phorton1/Arduino-theClock3/docs/wood.md

# theClock3 - Laser Cut and Assemble Wooden Parts (Build Continued)

**[Home](readme.md)** --
**[Design](design.md)** --
**[Plan](plan.md)** --
**Wood** --
**[Coils](coils.md)** --
**[Electronics](electronics.md)** --
**[Firmware](firmware.md)** --
**[Assemble](assemble.md)** --
**[Build](build.md)** --
**[Tuning](tuning.md)** --
**[UI](ui.md)** --
**[Software](software.md)** --
**[Troubles](troubles.md)** --
**[Notes](notes.md)**

On this page we will describe how to:

- [Cut the Wood](#1-cut-the-wood)
- Assemble the [Frame](#2-assemble-the-frame)
- Assemble the [Face](#3-assemble-the-face)
- Glue washers to the [Arms](#4-glue-washers-to-the-arms)
- Sand and paint the [Gears and ther small parts](#5-sand-and-paint-parts)
- Align and glue the [Gear Sets](#6-align-and-glue-gear-sets) together

Note that there are no *wood stains* used in this project.  All I use is a
lacquer based **clear coat** on the parts and let the natural colors of the
different types of wood show through.

## 1. Cut the Wood

Here is a screen grab of the Lightburn [AllParts.lbrn2](lightburn/all_parts.lbrn2)
project showing and naming all of the wooden parts that are laser cut.

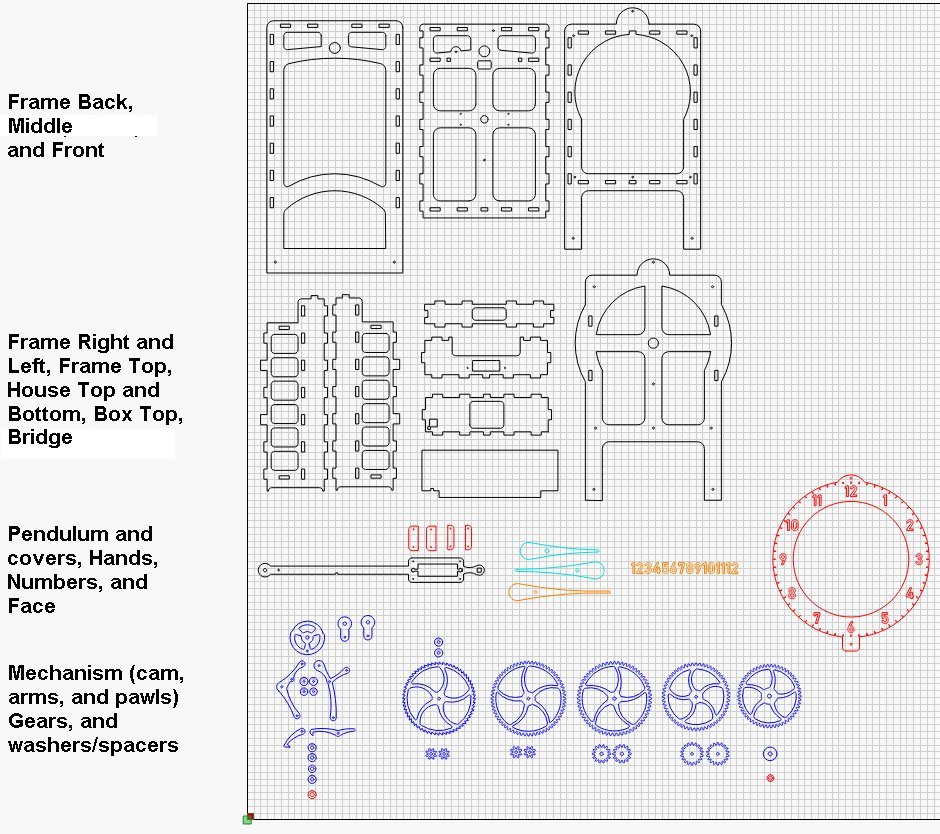
[picture p40: docs/images/wood-AllParts.jpg]


- <font color='black'><b>black</b></font> parts are cut from **cheap 3/16" plywood**
- <font color='blue'><b>blue</b></font> parts are cut from better quality **3/16" birch plywood**
- <font color='red'><b>red</b></font> parts are cut from **1/8" birch plywood**
- <font color='cyan'><b>cyan</b></font> parts are cut from **1/8" maple** hardwood
- <font color='orange'><b>orange</b></font> parts are cut from **1/8" walnut** hardwood

I specifically cut the **pendulum** out of better **3/16 walnut plywood** that
I happen to have.  It is more rigid and a bit thicker than the birch or cheap plywood.

I usually sand both sides of the frame *plywood* pieces with an electric
**palm sander** before cutting the parts out.  I sand the smaller pieces
individually after they are cut.

On my **10 Watt Diode Laser** I typically cut the 3/16" wood with two passes at
**95% power** and **140 mm per minute**.  I cut the 1/8 wood a bit quicker
at **90% power** and **150 mm per minute**.  Test cuts and adjustments
are required to get the best cut quality.

*There is **nothing worse** than cutting a sheet full of parts and finding that
the cuts did not go all the way through!!  It is usually impossible to fix it,
and so the wood gets wasted.  Therefore I prefer to **over-do** it a little bit,
even at the expense of **charring** the wood to ensure that all parts are
completely cut out.*

For the **smaller parts** (small gears, cam, arms, pawls, spacers, etc),
since I can usually fit them in the blank spaces of other parts, I typically print
twice as many as I need and select the better looking ones for the assembly.

There are separate **Lightburn Projects** in this repository for each of the different
pieces of wood that I cut.

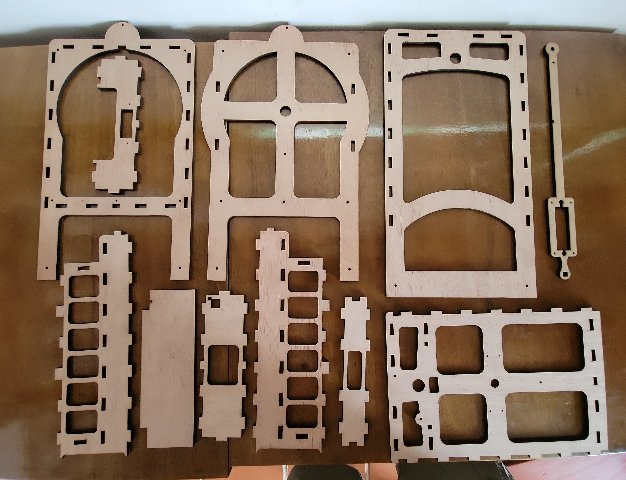
[picture p41: docs/images/wood-big_pieces.jpg]

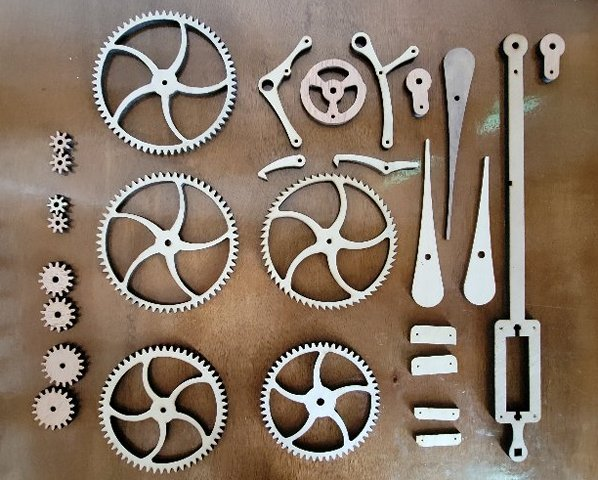
[picture p42: docs/images/wood-mechanism_and_gears.jpg]


Where possible, for all the big parts, immediately after cutting
I rub down the laser cuts with a **paper towel** to remove as much
of the charcoal as is easily done before moving them to my work table.
The process of cleaning and sanding the laser cut parts is surprisingly
*messy* and I find that I need to wash my hands often to prevent the
oil from my hands combining with the charcoal dust and leaving marks
in the wood.

It is **important** to keep track of, and to use the correct **wooden washers and spacers**
throughout the build process.  For example, there is only a *slight difference* between
the **12x2.85mm** spacers that support the arms, and are glued to the frame, and
the **11x3mm** washers that are glued to the front of the arms:

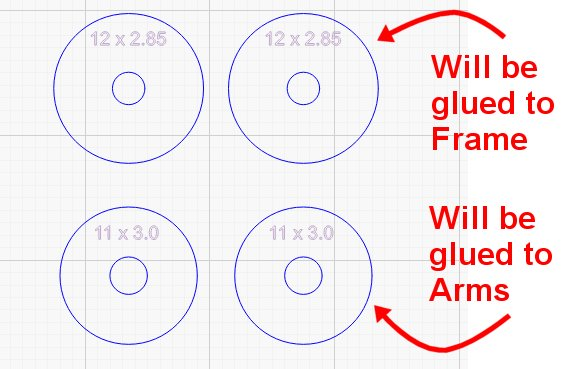
[picture p43: docs/images/wood-arm_and_frame_spacers.jpg]

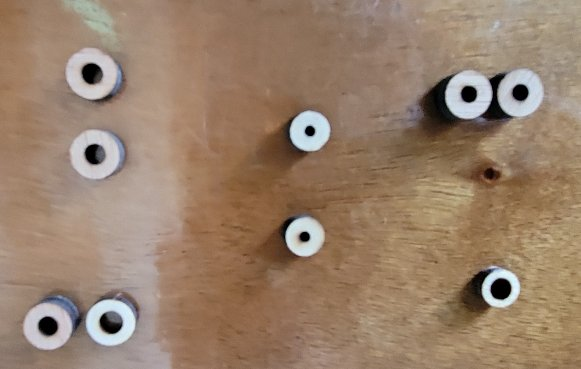
[picture p44: docs/images/wood-spacers_and_washers.jpg]


The **sizes** of the various washers and spacers is included as a
*non-cutting layer* in the various **Lightburn** projects so that
can see them, but it is **up to you** to keep track of them!

## 2. Assemble the Frame

It is important to dry fit the frame together and know ahead
of time how you will assemble and clamp it.  It is also
is important to understand that there are four tabs
that *extend out of the frame front* onto which the **bridge** (which
is NOT glued, but which is attached with screws) is aligned.

I usually use a piece of 2x2 wood as a mallet to tap the
pieces together as I align them.  As is typical with these kinds
of **box joints**, some tapping, force, and/or slight bending of the pieces
may be necessary to get the tabs to go into the slots.

Glue the frame together, in *one fell swoop*, with **wood glue** before
clamping it together!! The order of assembly of the frame is important,
is shown in the below **animated GIF**, and it is necessary that **all
pieces are in place, and square** before any **glue sets up** !!!

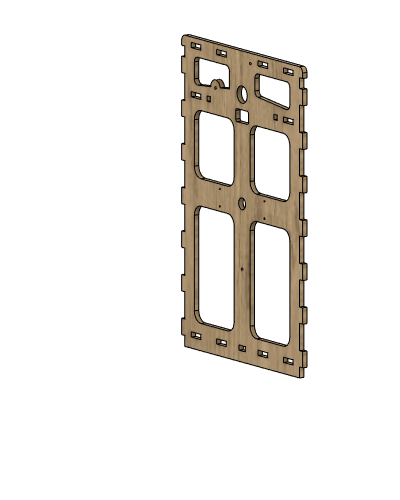
[picture p45: docs/images/wood-frame_assembly.gif]


Starting the with the **middle** frame piece, glue the
**house top**, **house bottom**, and **frame top** to it. Then,
while holding those pieces roughly in place, turn it on it's side
and glue **one of the frame sides to that**, then flip it over and
glue the **other frame side to that**. Then glue
the **frame back**, and, finally, **the frame front**.

**Clamp** the frame together and let it dry thoroughly ...

When it is thoroughly dry, lightly sand **the assembled frame**,
and the separate **bridge piece** with 300 grit sandpaper.

### Glue the Arm Spacers to the Frame

- *thread* **M3x8 machine screws** through the two **12x2.85mm** Arm Spacers
- *apply* **Wood Glue** to the back of the spacers
- *screw* them into the *Frame* until they are **tight** and let the glue *dry thoroughly*
- *remove* the screws

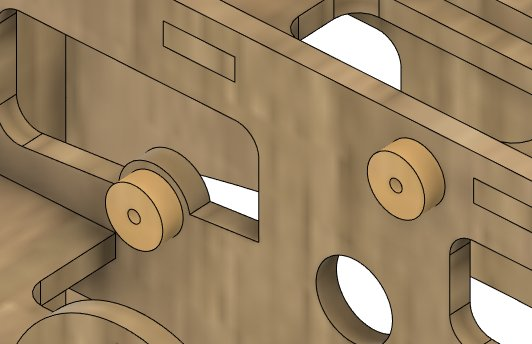
[picture p46: docs/images/wood-arm_spacers_glued.jpg]


### Clear Coat the Frame and Bridge

**Clear Coat the Frame and Bridge** by applying 2-3 clear-coats to the interior
of the frame and back of the bridge, and 3-4 coats to the
exterior and front.

## 3. Assemble the Face

The **hash marks** on the *face* are engraved before cutting.
**Finish sand** the face **before** cutting it and try to handle
it as little as possible before clear-coating!

**IT IS IMPORTANT TO KEEP THE LITTLE PIECES INSIDE OF THE 6,8,9, and 10 NUMBERS
WHEN CUTTING THE FACE**.  As I result I **do not** print the face
on my honeycomb laser printing surface or those small pieces will
fall into the honeycomb, be harder than heck to find, and will likely
be damaged by the laser.  Instead I cut the face **directly
on the laser table** and carefully keep track of where the
little pieces come from, and where they go, so that I can *match the grain*
when I re-insert them during the face assembly.

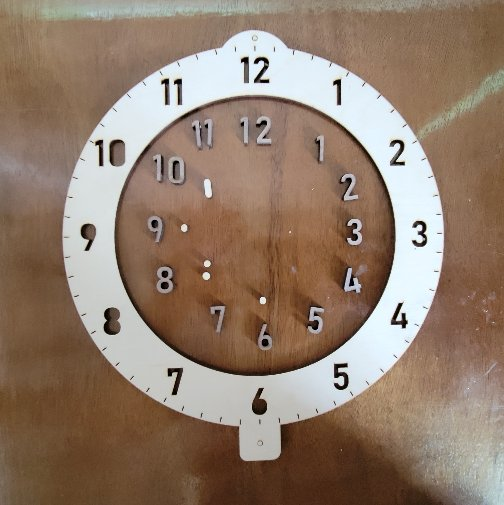
[picture p47: docs/images/wood-face_and_numbers.jpg]

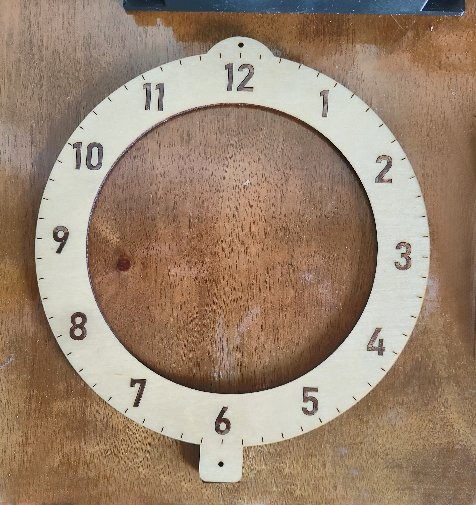
[picture p48: docs/images/wood-face_finished.jpg]


After wiping it off with a clean paper towel,
I place the **face** downwards on a sheet of wax paper and glue
the numbers in with **white glue**, inserting them from the back
so that they are *flush with the front of the face*.  Then
after the glue is thoroughly dry, I rough sand the back as needed
and *gently* sand the face with 320 grit sand paper until it
looks clean enough to clear coat.  **Vacuum** and wipe the dust
off with a clean paper towel.

I try to clear coat things as soon after I finish-sand them as
possible.  I clear coat the important (front) surface first so
that it is sealed as cleanly as possible before I flip them over
and paint the backs.  I apply as many as 5-6 clear-coats on the
face of the clock, sanding each coat lightly with 320 grit, and
rubbing the last coat down with a clean paper towel,
to get a nice sheen.

## 4. Glue Washers to the Arms

- Apply **wood glue** to the back of the two **11x3mm** *Arm Washers*
- **Align** and *press* the Washers onto the Arms

It is **important** that the Washers are *aligned* with the holes in the *Arms*.
They need to be aligned such that they **turn freely** on **M3 machine screws**

This is best done **by eye** and by **holding the parts together** with your
*fingers* until the glue has gotten to the point where you can, perhaps,
apply a *clamp* (or lay them down and put a small *weight* on top of them).

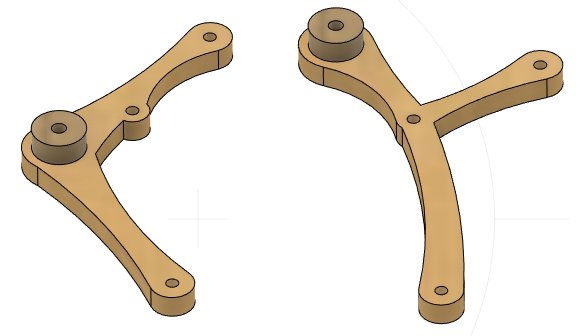
[picture p49: docs/images/wood-glue_washers_to_arms.jpg]


## 5. Sand and Paint Parts

My *least favorite* part of the entire build process is **sanding the gears**
and the rest of the small parts.

A. **Inspect each gear carefully**.  If there are any *defective* or *delaminated*
teeth they need to be **repaired** (or another instance of the particular gear
needs to be re-cut with the laser).  I have used wood glue, epoxy glue, and
even the **baking soda and super glue** trick to repair individual teeth on
gears before and during the sanding process.

B. **Make sure the ends of your brass tubes are sanded and smooth** before
inserting them into parts so that they don't damage the holes!
Test fit all the pieces onto their appropriate brass tubes.
Make sure the **pendulum, gears, cam,** and **hands** fit onto
the correct sized brass tubes so that they **fit snugly**.
You *may* need to lightly sand the holes so that the tubes go in, but,
**DONT OVERDO IT!!**

It is better if the *cam and pendulum* are a little easier to move
when later adjusting the clock but it is particularly important that
the **hands are snug** when compression fit on their particular brass tubes.

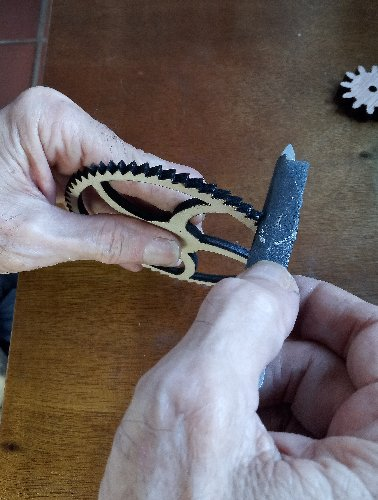
[picture p50: docs/images/wood-gears1.jpg]

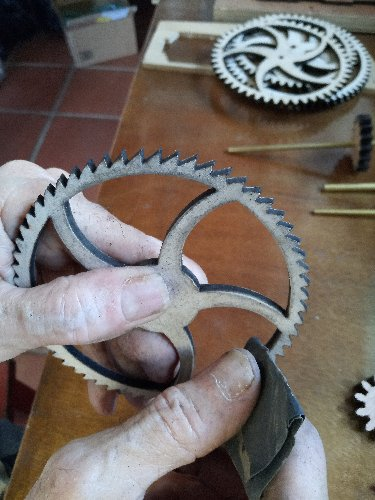
[picture p51: docs/images/wood-gears2.jpg]


C. For **each gear** and **every tooth** sand them *lightly* with 220 or 300
grit sand paper. You have to be very careful when sanding the gears to **NOT**
delaminate the plywood and chip the gears!!

D. For the **big gears**, after sanding the teeth, sand the **interior openings**
then clean everything with a paper towel before sanding the **back** and **face**
of each gear until they are clean enough to clear-coat.  This is an *art* more
than it is a *science*.  **Do your best!!** ... you won't regret taking the
time needed to make the gears as functionally and aesthetically
nice as possible.

E. The **faces of the pawls** and the **contact points** on the cam will also need
to be smooth.  The process varies with my feelings.  Sometimes I clear-coat them
first and then only sand these pieces once afterwards to minimize the
amount of material removed.

F. In any case, it is important to **apply several clear-coats** to the gears,
particularly *saturating the **teeth** and **contact points***.
The clear coat adds significant strength and **wear resistance** to these
parts.

G. After clear coating and allowing to dry thoroughly, **re-sand each tooth**
and all **contact points** to minimize friction.  I like to do the second
sanding of the small (pinon) gears by aligning each pair of pinon gears
on a **brass tube** and then doing the second pass at sanding their teeth
*before* doing any gluing.

I also give a *light sand* with *320 grit* paper to all of the **faces**
of the *gears, arms, pawls,* and *arm supports* .. any place where two
pices of wood will be facing each other.

## 6. Align and Glue Gear Sets

Each **gear set** consists of one large gear with two smaller *pinon gears*
(or one *spacer*) glued together in a *stack*.  I use *5 minute epoxy* to glue the gears together.

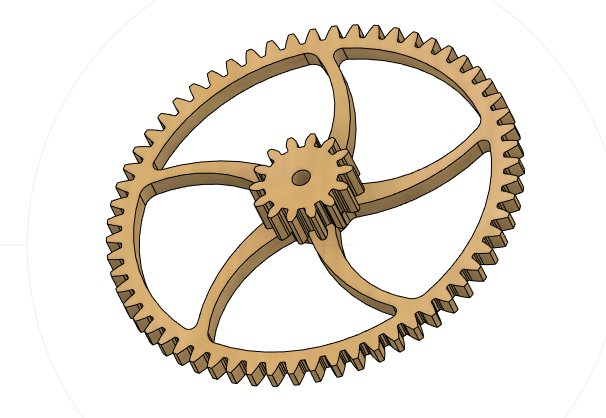
[picture p52: docs/images/wood-gears0.jpg]


The following picture shows the big gears and each pair of smaller gears
(or the single spacer) to be glued to the big gears, in their **proper orientation**.

- the **seconds wheel** is glued to the two (smallest) **min1a** gears
- the (largest) **min1b** gear is glued to the two (2nd smallest) **min2a** gears
- the (2nd largest) **min2b** gear is glued to the two **hour1a** gears
- the **hour1b** gear is glued to the two **hours2a** gears, and
- the final (smallest big) **hours2b** gear is glued to the (single) **hour spacer**

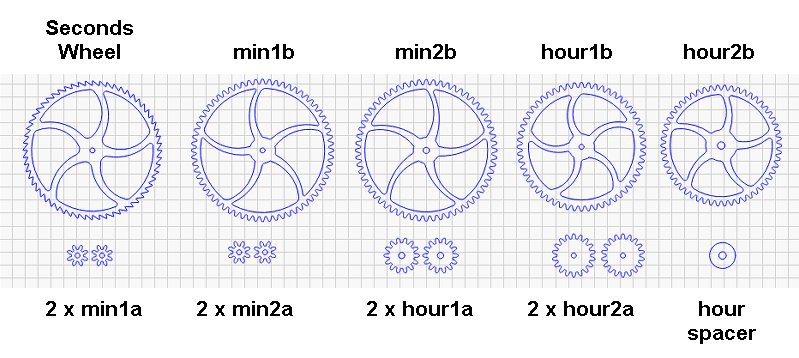
[picture p53: docs/images/wood-gears_and_names.jpg]


A. Jury rig an apparatus so that you can **spin the gears** and **align them**
as the glue is setting up.  For instance the **4 mm tubes** turn nicely
on **3mm threaded rods**, so for those gears that go on 4mm tubes I rig
up a contraption with a 3mm threaded rod on which I can spin the 4mm tube
and it's gears.  Likewise the 5mm tubes spin nicely on 4mm tubes, so I
then rig it up with a protruding (fixed) 4mm tube so that I can spin the
5mm tubes and it's gears during the alignment process.

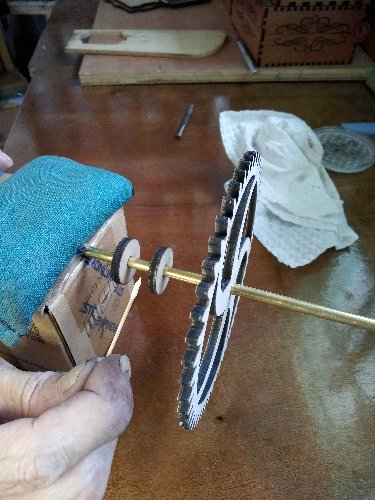
[picture p54: docs/images/wood-gears3.jpg]


*Note: above photo is an assembly from a previous clock.  Be sure
to glue the **correct gears** together (as shown in the previous image) in their
**proper orientation!!***
Also ***note*** that, wheras there are always **two** small *pinon gears* glued
to the larger gears, there is **only one** *3/16" spacer* glued to the front
of the *Hours2b* gear.

B. **BE CAREFUL NOT TO GLUE THE GEARS TO THE TUBES!!**.  We will
**cut the tubes later** and we don't want to damage the tubes
during this process.

C. Apply a small amount of **5 minute epoxy** glue as needed,
press the three gears together on the tube, **spin** them, and **adjust**
them get them as **square as possible** before the epoxy sets up.

Any *wobbles* introduced at this point will be permanent (as I learned
the hard way a few times) so **take your time** and glue and **align**
each gear sub-assembly on the (raw) brass tubes. If you end up with
a **wobbly gear** it is probably better to just re-cut, re-sand,
and create a new assembly than to try to use a mis-aligned gear
asembly in your finished clock!

D. After the glue has **set up** (about 5 minutes), slide the sub-assembled
gears off the tubes and set them aside.  **CLEAN THE TUBES WITH ALCOHOL**
after each subassembly.

**Next:** Winding the [**Coils**](coils.md) ...
