phorton1/Arduino-theClock3/docs/images/coils-final2.jpg

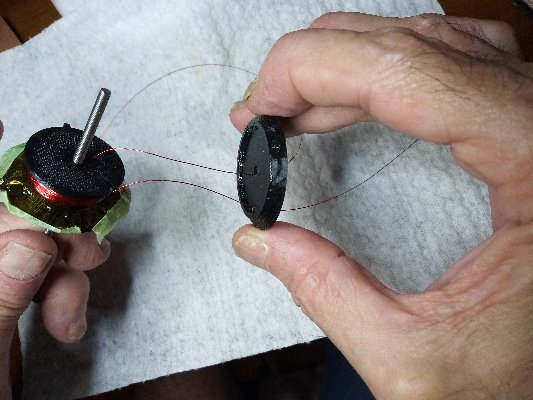
docs/images/coils-final2.jpg
