phorton1/Arduino-theClock3/docs/images/coils-insert2.jpg

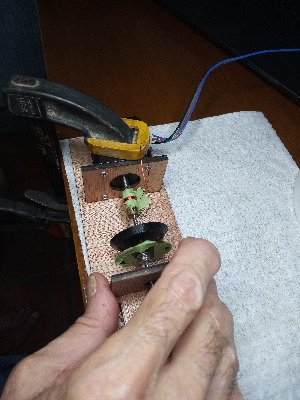
docs/images/coils-insert2.jpg
