phorton1/Arduino-theClock3/docs/images/ui-stats.jpg

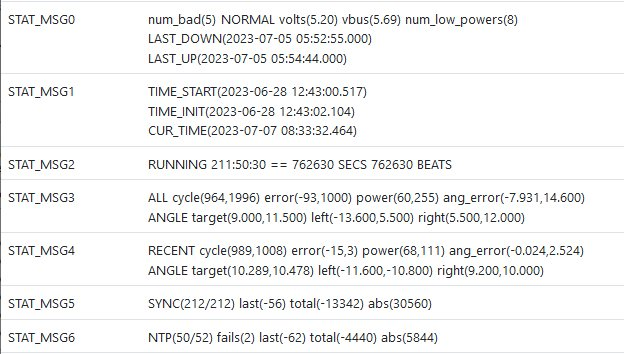
docs/images/ui-stats.jpg
