phorton1/Arduino-theClock3/docs/images/UPS1.png

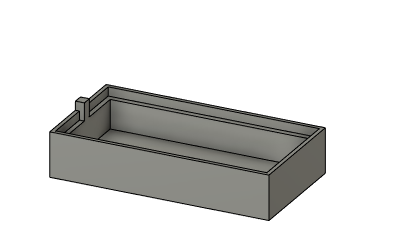
docs/images/UPS1.png
