phorton1/Arduino-theClock3/docs/images/UPS3.png

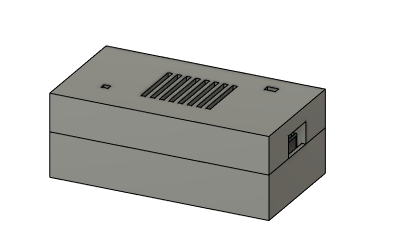
docs/images/UPS3.png
