phorton1/Arduino-theClock3/docs/fusion/dxf/spacers_main_front.dxf

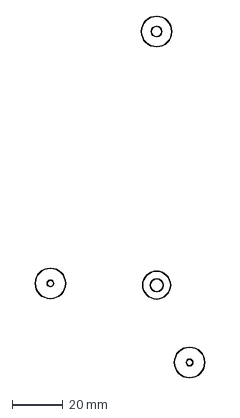
[picture p100: CAD file, 2023-05-27]
docs/fusion/dxf/spacers_main_front.dxf
66.8 x 142.5 mm
