phorton1/Arduino-theClock3/docs/fusion/dxf/bridge.dxf

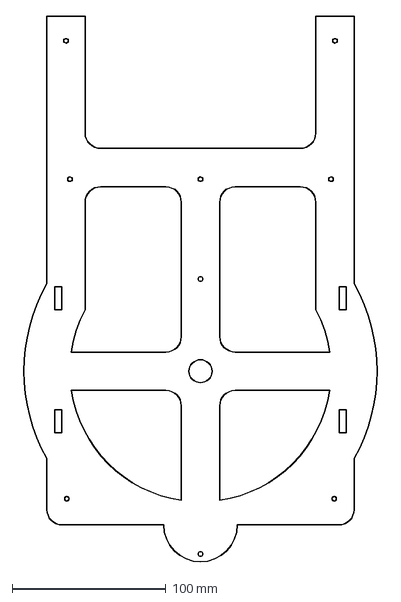
[picture p101: CAD file, 2023-06-24]
docs/fusion/dxf/bridge.dxf
240.0 x 355.0 mm
