phorton1/Arduino-theClock3/docs/fusion/stl/ups_bottom.stl

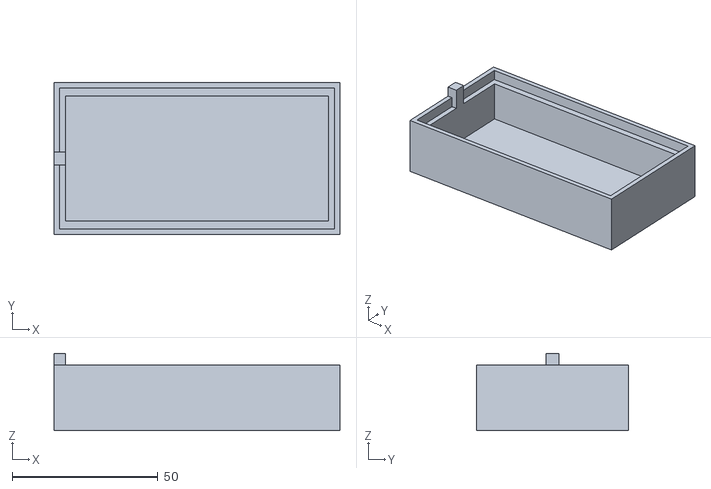
[picture p102: CAD file, 2023-07-10]
docs/fusion/stl/ups_bottom.stl
98.0 x 52.0 x 26.5
