phorton1/Arduino-theClock3/docs/prusa/UPS.3mf

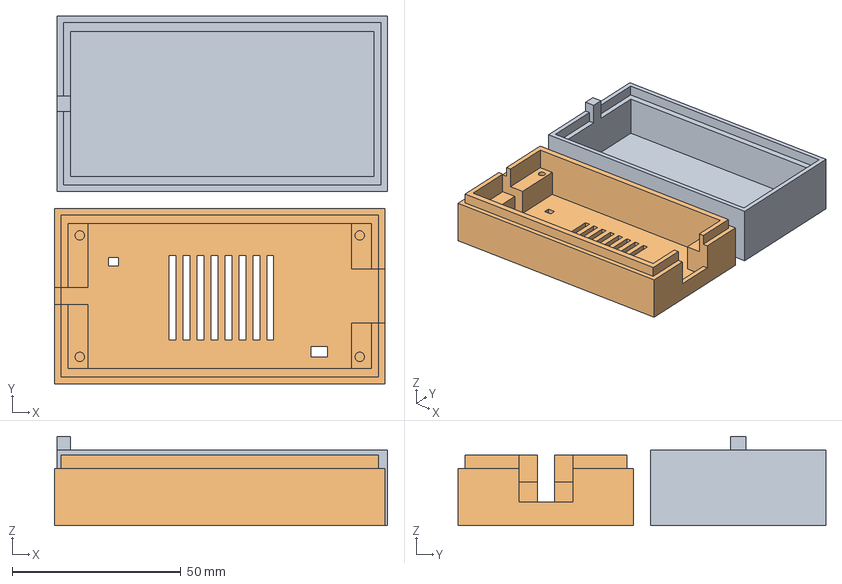
[picture p103: CAD file, 2023-07-10]
docs/prusa/UPS.3mf
98.7 x 109.0 x 26.5 mm
ups_bottom.stl
ups_top.stl
