phorton1/Arduino-theClock3/docs/fusion/dxf/arms.dxf

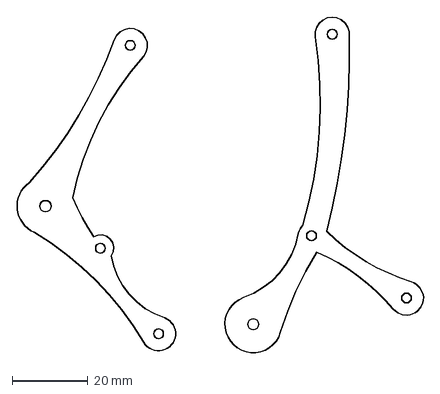
[picture p104: CAD file, 2023-05-27]
docs/fusion/dxf/arms.dxf
107.6 x 89.0 mm
