phorton1/Arduino-theClock3/docs/fusion/stl/the_box_usb.stl

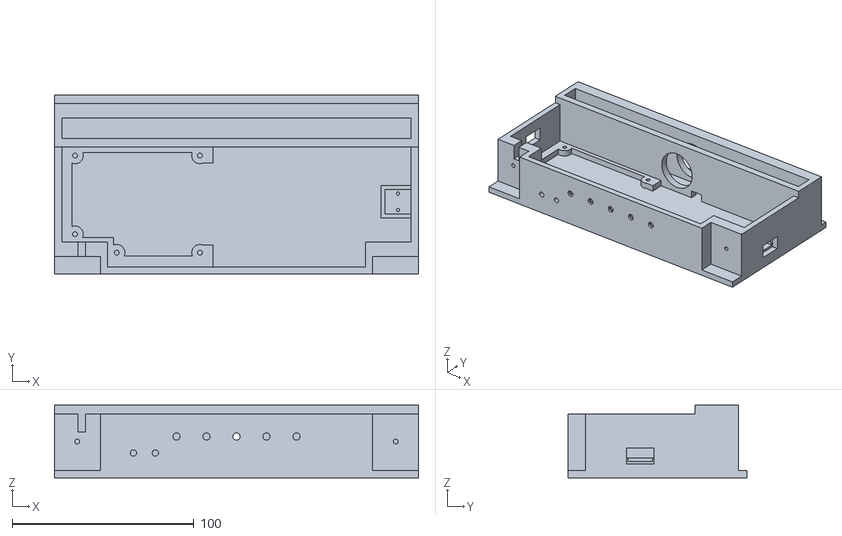
[picture p105: CAD file, 2023-07-08]
docs/fusion/stl/the_box_usb.stl
200.0 x 98.4 x 40.0
