phorton1/Arduino-theClock3/docs/fusion/stl/ups_top.stl

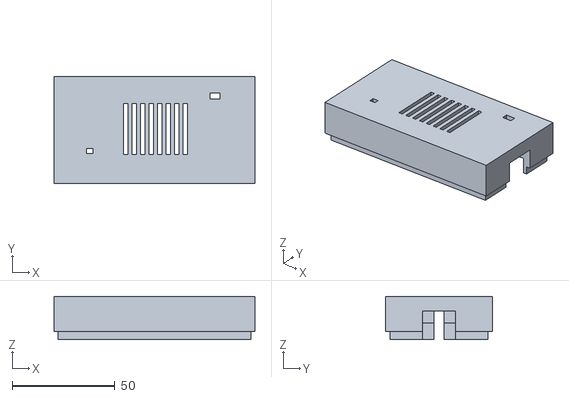
[picture p106: CAD file, 2023-06-25]
docs/fusion/stl/ups_top.stl
98.0 x 52.0 x 21.0
