phorton1/Arduino-theClock3/docs/fusion/dxf/spacers_arm_front.dxf

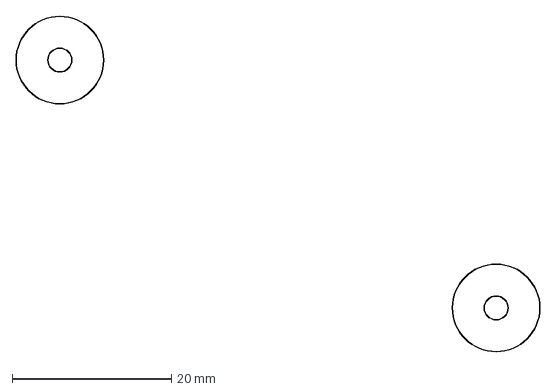
[picture p107: CAD file, 2023-05-27]
docs/fusion/dxf/spacers_arm_front.dxf
65.8 x 42.2 mm
