phorton1/Arduino-theClock3/docs/prusa/coil_set.3mf

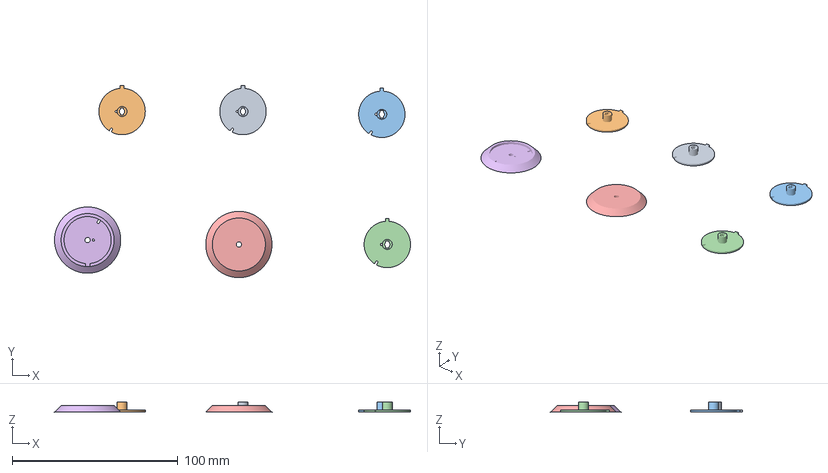
[picture p108: CAD file, 2023-06-17]
docs/prusa/coil_set.3mf
214.9 x 116.1 x 6.30 mm
bobbin.stl x 4
tool_left.stl
tool_right.stl
