phorton1/Arduino-theClock3/docs/fusion/dxf/frame_front.dxf

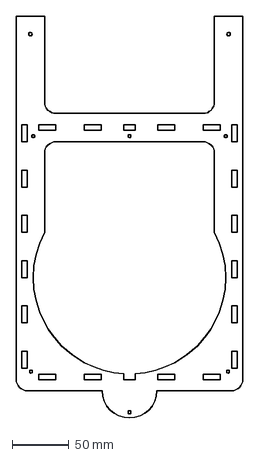
[picture p109: CAD file, 2023-05-08]
docs/fusion/dxf/frame_front.dxf
200.0 x 355.0 mm
