phorton1/Arduino-theClock3/docs/prusa/lenses.3mf

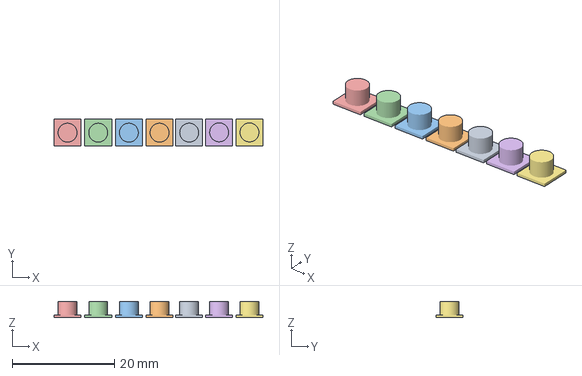
[picture p110: CAD file, 2023-06-14]
docs/prusa/lenses.3mf
40.9 x 5.36 x 3.20 mm
lens1.stl x 7
