phorton1/Arduino-theClock3/docs/fusion/dxf/pendulum.dxf

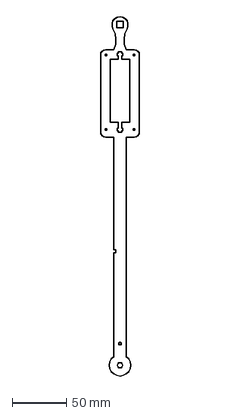
[picture p111: CAD file, 2023-05-08]
docs/fusion/dxf/pendulum.dxf
36.0 x 333.1 mm
