phorton1/Arduino-theClock3/docs/fusion/stl/tool_right.stl

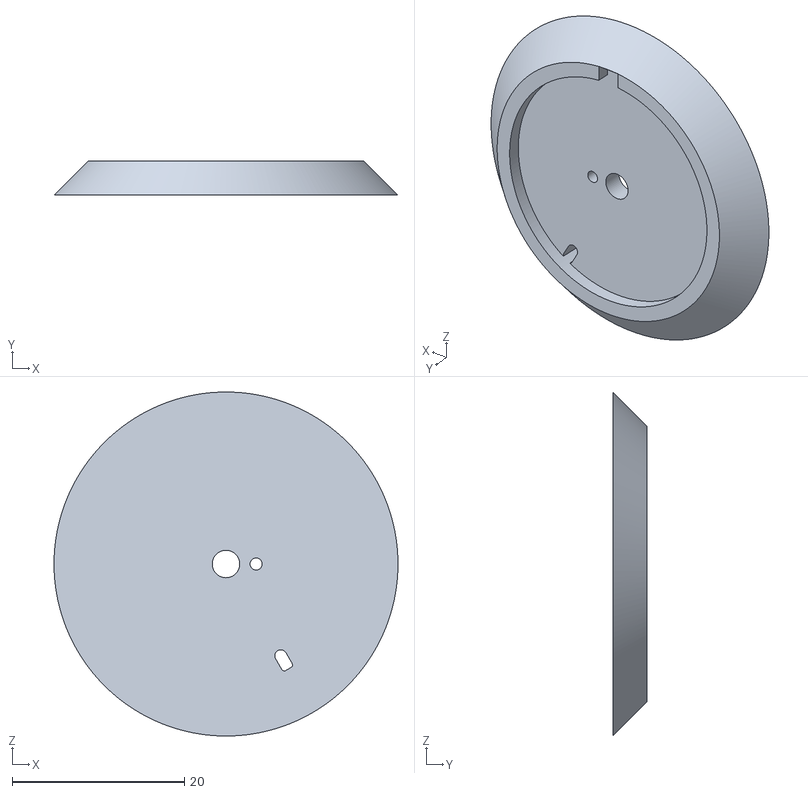
[picture p112: CAD file, 2023-06-17]
docs/fusion/stl/tool_right.stl
40.0 x 4.00 x 40.0
