phorton1/Arduino-theClock3/docs/fusion/dxf/frame_left.dxf

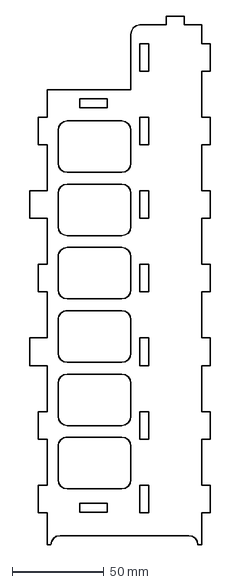
[picture p113: CAD file, 2023-05-08]
docs/fusion/dxf/frame_left.dxf
98.4 x 287.5 mm
