phorton1/Arduino-theClock3/docs/fusion/stl/tool_left.stl

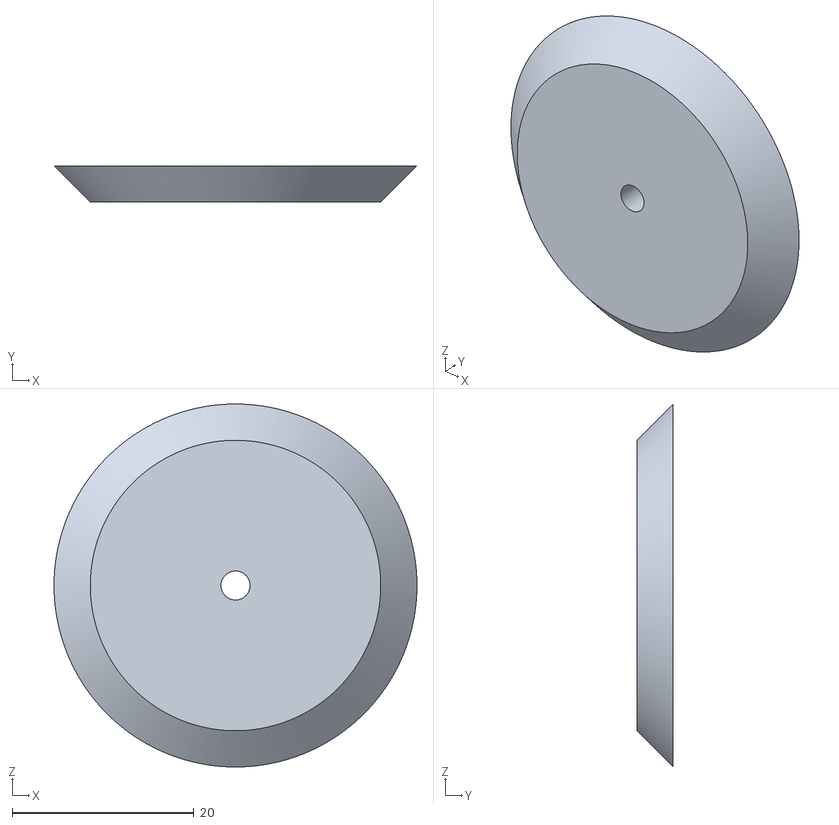
[picture p114: CAD file, 2023-06-17]
docs/fusion/stl/tool_left.stl
40.0 x 4.00 x 40.0
