phorton1/Arduino-theClock3/docs/fusion/dxf/frame_back.dxf

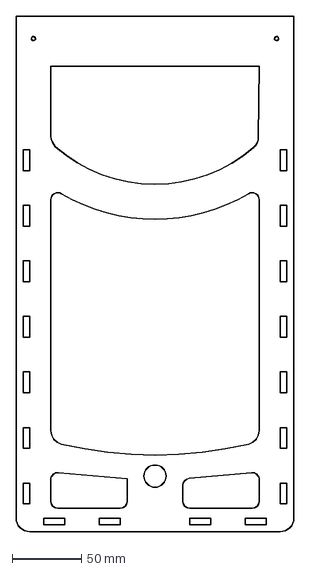
[picture p115: CAD file, 2023-05-08]
docs/fusion/dxf/frame_back.dxf
200.0 x 371.0 mm
