phorton1/Arduino-theClock3/docs/fusion/stl/usb_micro_mount.stl

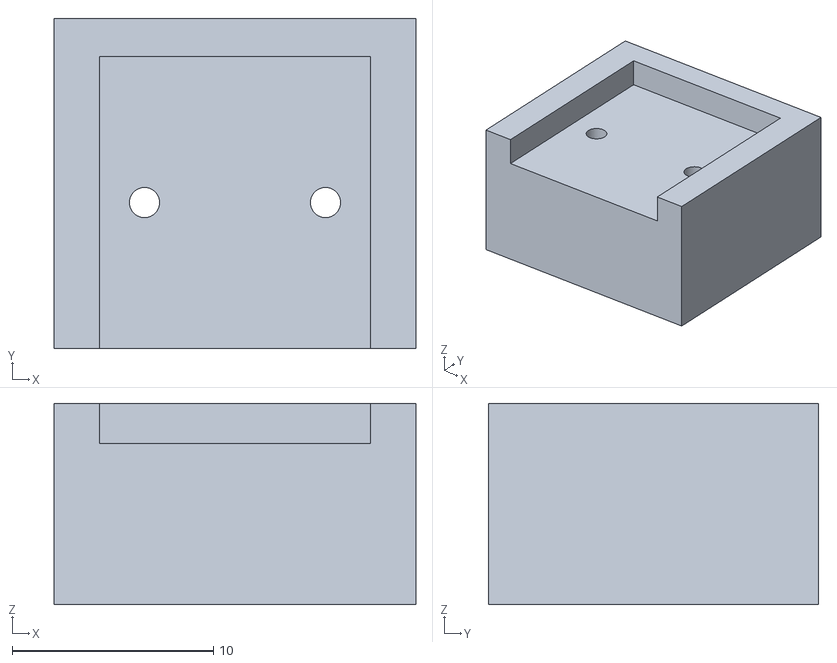
[picture p116: CAD file, 2023-06-01]
docs/fusion/stl/usb_micro_mount.stl
18.0 x 16.4 x 10.0
