phorton1/Arduino-theClock3/docs/prusa/15x13_bearing_adapter.3mf

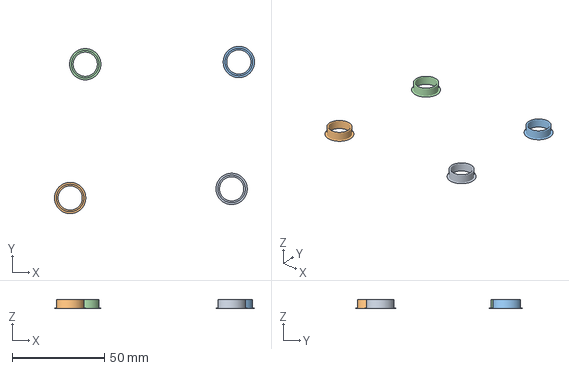
[picture p117: CAD file, 2023-05-21]
docs/prusa/15x13_bearing_adapter.3mf
108.5 x 90.7 x 5.00 mm
15x13_bearing_adapter.stl x 4
