phorton1/Arduino-theClock3/docs/fusion/dxf/frame_middle.dxf

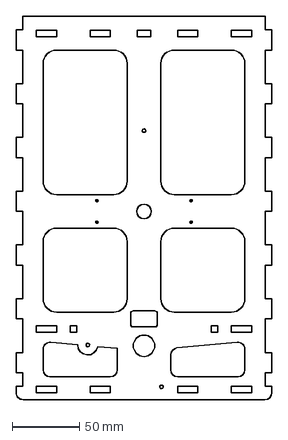
[picture p118: CAD file, 2023-05-08]
docs/fusion/dxf/frame_middle.dxf
190.0 x 285.0 mm
