phorton1/Arduino-theClock3/docs/fusion/stl/15x13_bearing_adapter.stl

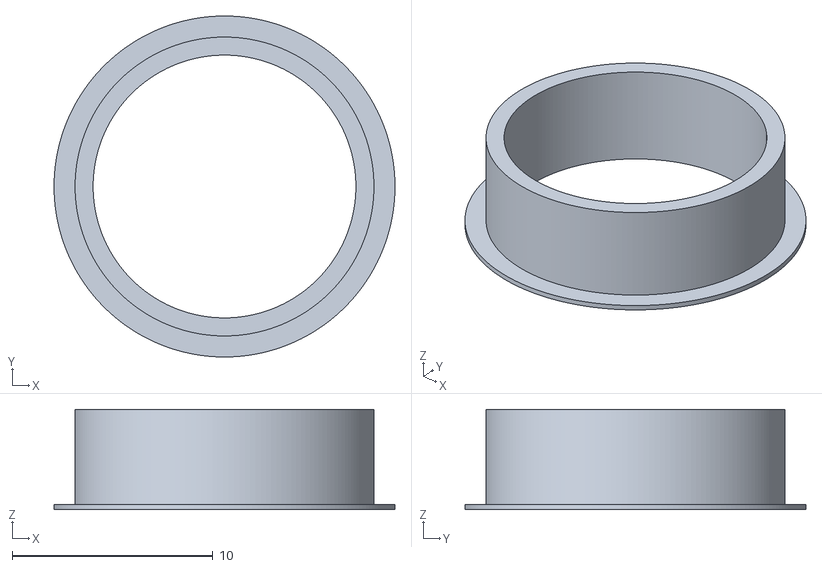
[picture p119: CAD file, 2023-05-21]
docs/fusion/stl/15x13_bearing_adapter.stl
17.0 x 17.0 x 5.00
