phorton1/Arduino-theClock3/docs/prusa/spacers.3mf

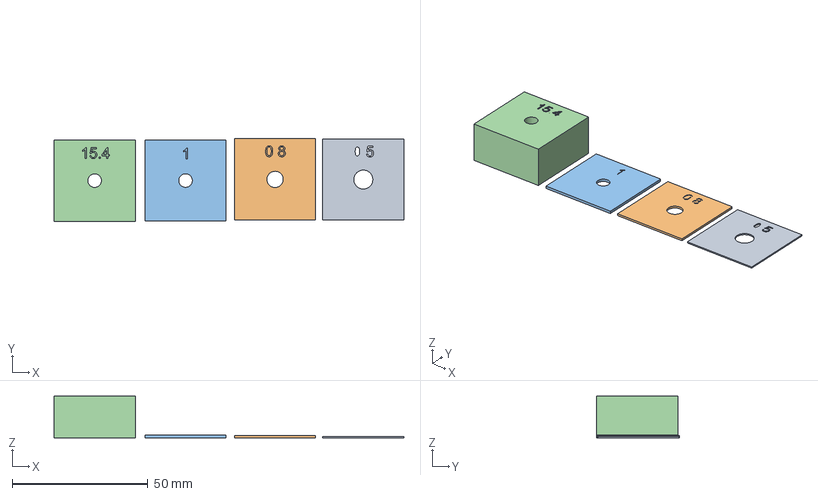
[picture p120: CAD file, 2023-05-08]
docs/prusa/spacers.3mf
129.1 x 30.5 x 15.4 mm
spacer0.5.stl
spacer0.8.stl
spacer1.stl
spacer15.4.stl
