phorton1/Arduino-theClock3/docs/fusion/dxf/pawls.dxf

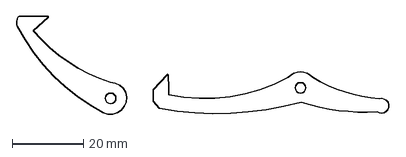
[picture p121: CAD file, 2023-04-28]
docs/fusion/dxf/pawls.dxf
104.8 x 28.3 mm
