phorton1/Arduino-theClock3/docs/fusion/stl/spacer15.4.stl

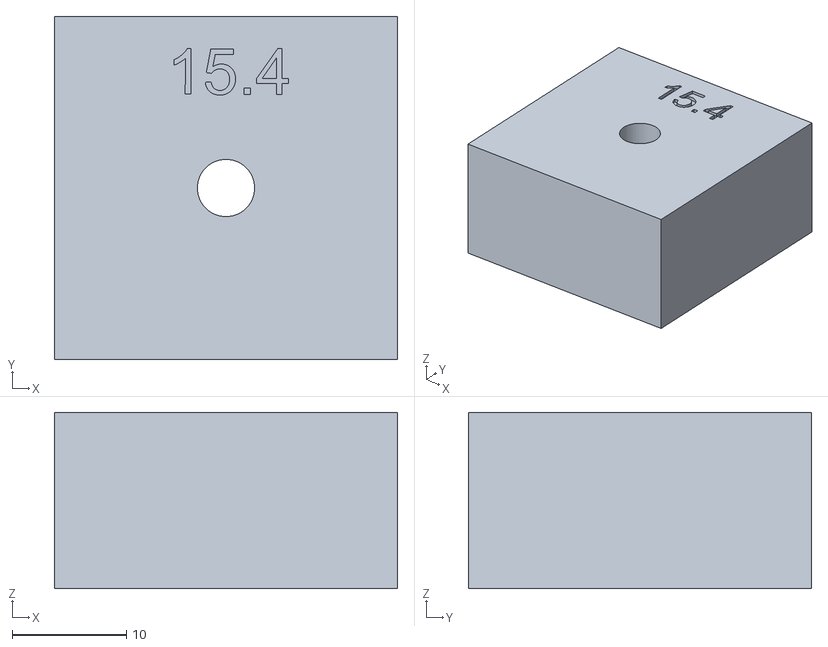
[picture p122: CAD file, 2023-05-08]
docs/fusion/stl/spacer15.4.stl
30.0 x 30.0 x 15.4
