phorton1/Arduino-theClock3/docs/prusa/magnet_holder.3mf

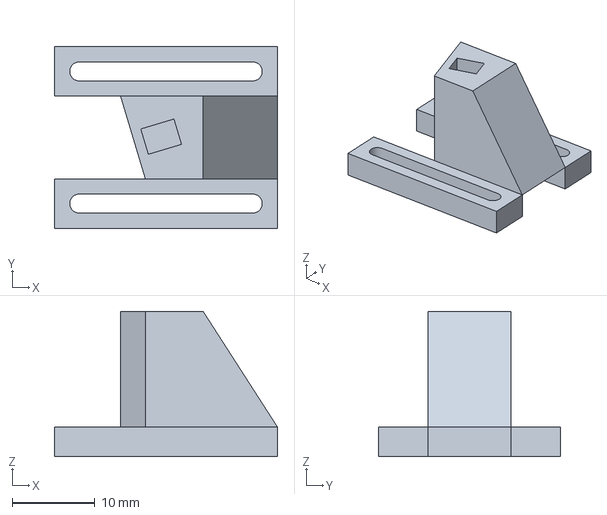
[picture p123: CAD file, 2023-04-28]
docs/prusa/magnet_holder.3mf
27.0 x 22.0 x 17.6 mm
