phorton1/Arduino-theClock3/docs/fusion/dxf/cam.dxf

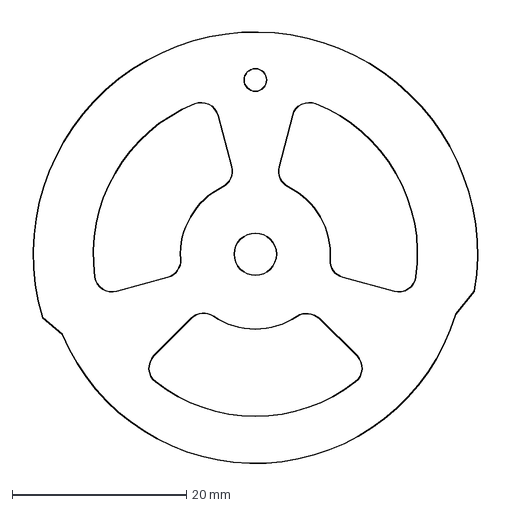
[picture p124: CAD file, 2023-04-08]
docs/fusion/dxf/cam.dxf
54.3 x 51.8 mm
