phorton1/Arduino-theClock3/docs/fusion/stl/spacer1.stl

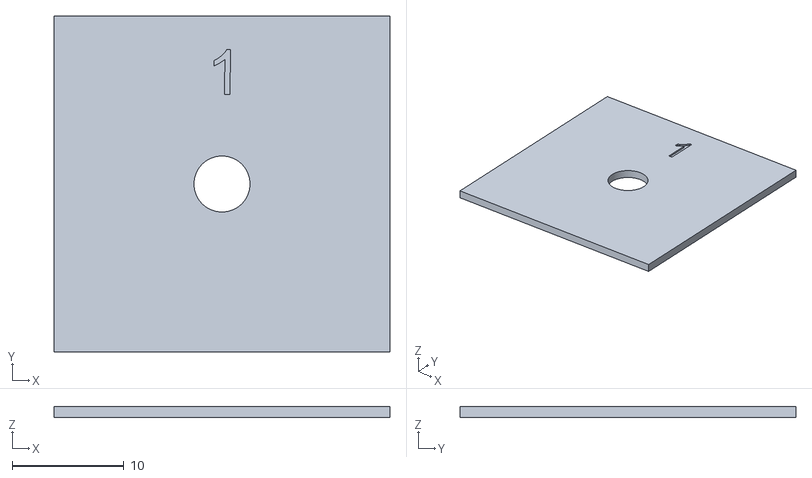
[picture p125: CAD file, 2023-05-08]
docs/fusion/stl/spacer1.stl
30.0 x 30.0 x 1.00
