phorton1/Arduino-theClock3/docs/prusa/wire_tie1.3mf

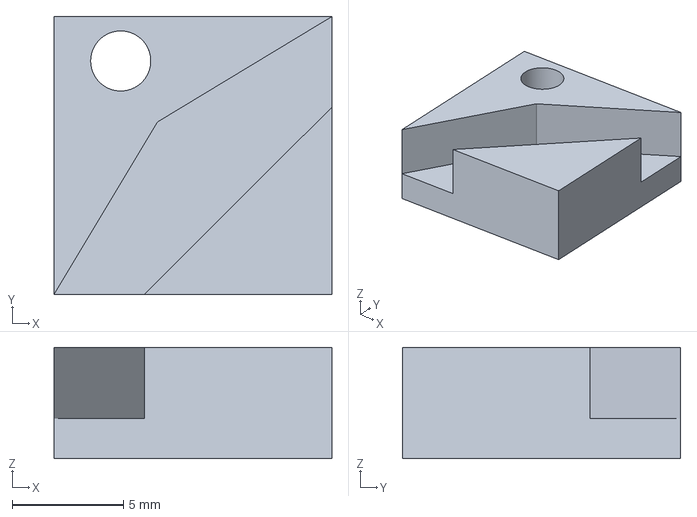
[picture p126: CAD file, 2023-03-30]
docs/prusa/wire_tie1.3mf
12.5 x 12.5 x 5.00 mm
