phorton1/Arduino-theClock3/docs/fusion/dxf/pendulum_covers_and_spacers.dxf

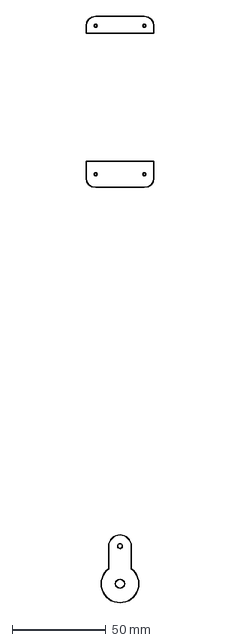
[picture p127: CAD file, 2023-03-27]
docs/fusion/dxf/pendulum_covers_and_spacers.dxf
36.0 x 312.0 mm
