phorton1/Arduino-theClock3/docs/fusion/stl/spacer0.5.stl

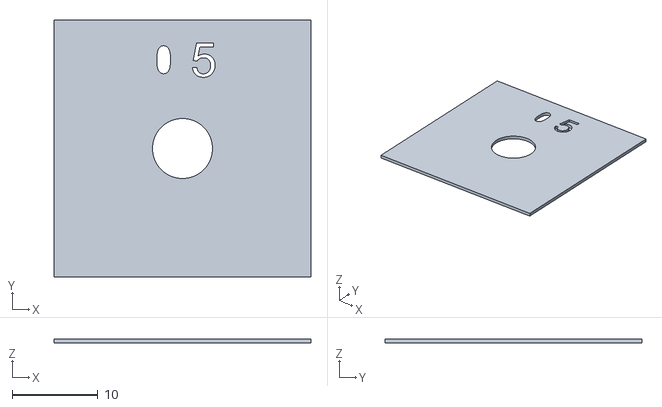
[picture p128: CAD file, 2023-05-08]
docs/fusion/stl/spacer0.5.stl
30.0 x 30.0 x 0.5
