phorton1/Arduino-theClock3/docs/prusa/sensor_housing.3mf

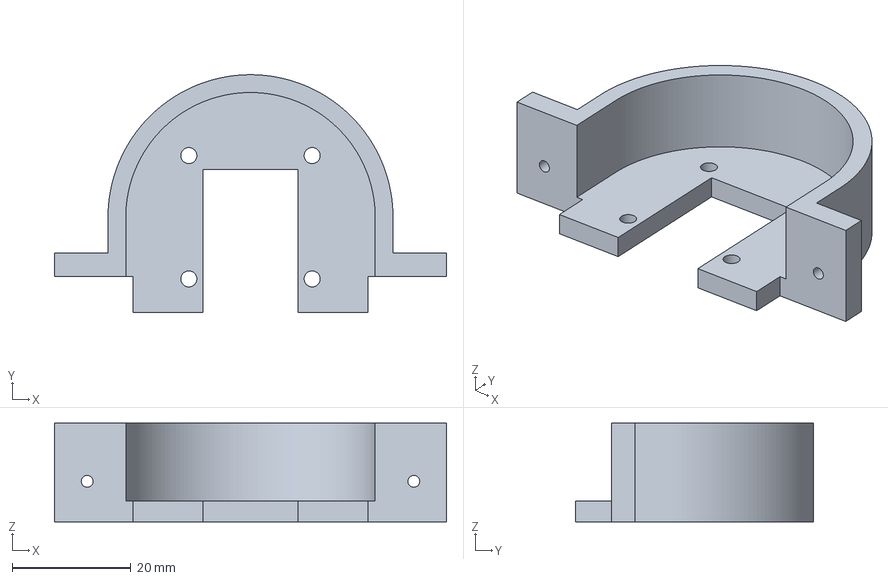
[picture p129: CAD file, 2023-03-21]
docs/prusa/sensor_housing.3mf
66.0 x 40.0 x 16.6 mm
