phorton1/Arduino-theClock3/docs/fusion/dxf/house_top.dxf

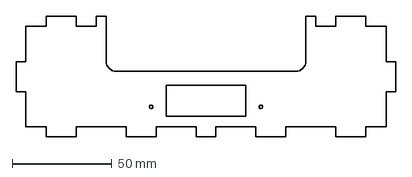
[picture p130: CAD file, 2023-03-27]
docs/fusion/dxf/house_top.dxf
190.0 x 60.1 mm
