phorton1/Arduino-theClock3/docs/fusion/stl/spacer0.8.stl

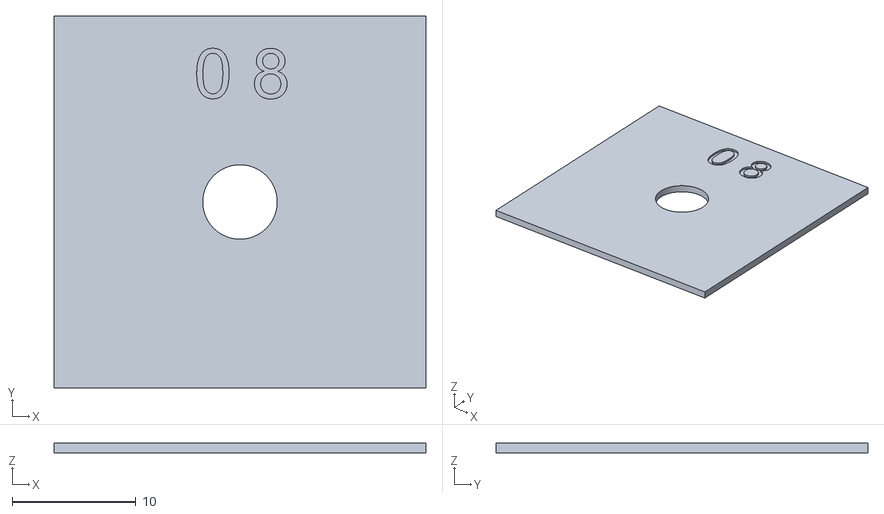
[picture p131: CAD file, 2023-05-08]
docs/fusion/stl/spacer0.8.stl
30.0 x 30.0 x 0.8
