phorton1/Arduino-theClock3/docs/fusion/dxf/box_top.dxf

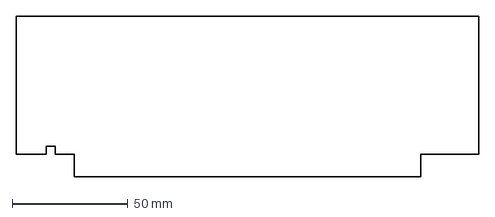
[picture p132: CAD file, 2023-03-25]
docs/fusion/dxf/box_top.dxf
200.0 x 69.5 mm
