phorton1/Arduino-theClock3/docs/fusion/dxf/house_bottom.dxf

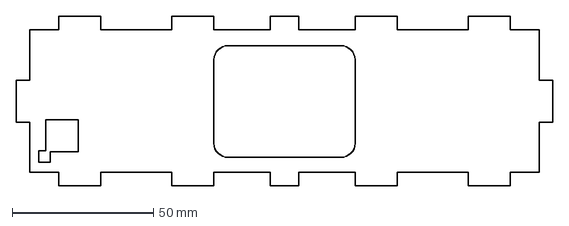
[picture p133: CAD file, 2023-03-25]
docs/fusion/dxf/house_bottom.dxf
190.0 x 60.1 mm
