phorton1/Arduino-theClock3/docs/fusion/dxf/hour1a.dxf

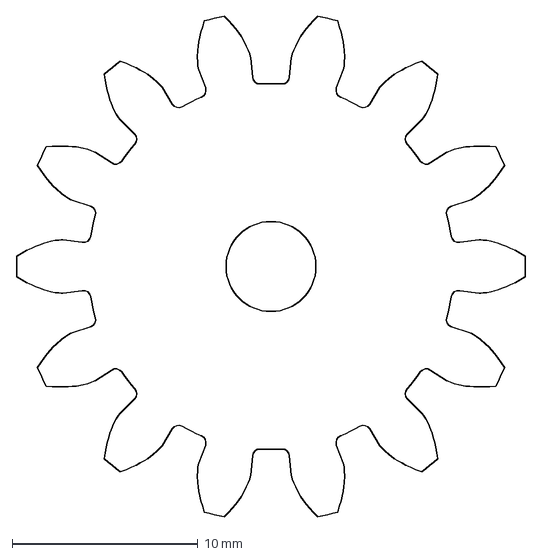
[picture p134: CAD file, 2023-03-21]
docs/fusion/dxf/hour1a.dxf
27.4 x 27.0 mm
