phorton1/Arduino-theClock3/docs/fusion/dxf/min2a.dxf

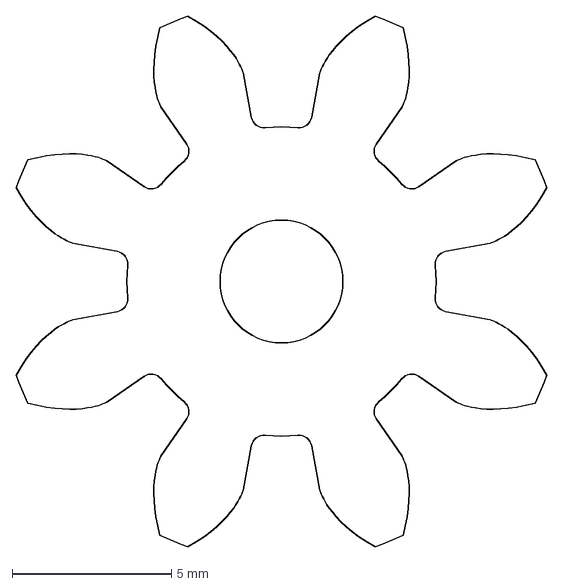
[picture p135: CAD file, 2023-03-21]
docs/fusion/dxf/min2a.dxf
16.7 x 16.7 mm
