phorton1/Arduino-theClock3/docs/fusion/stl/lens1.stl

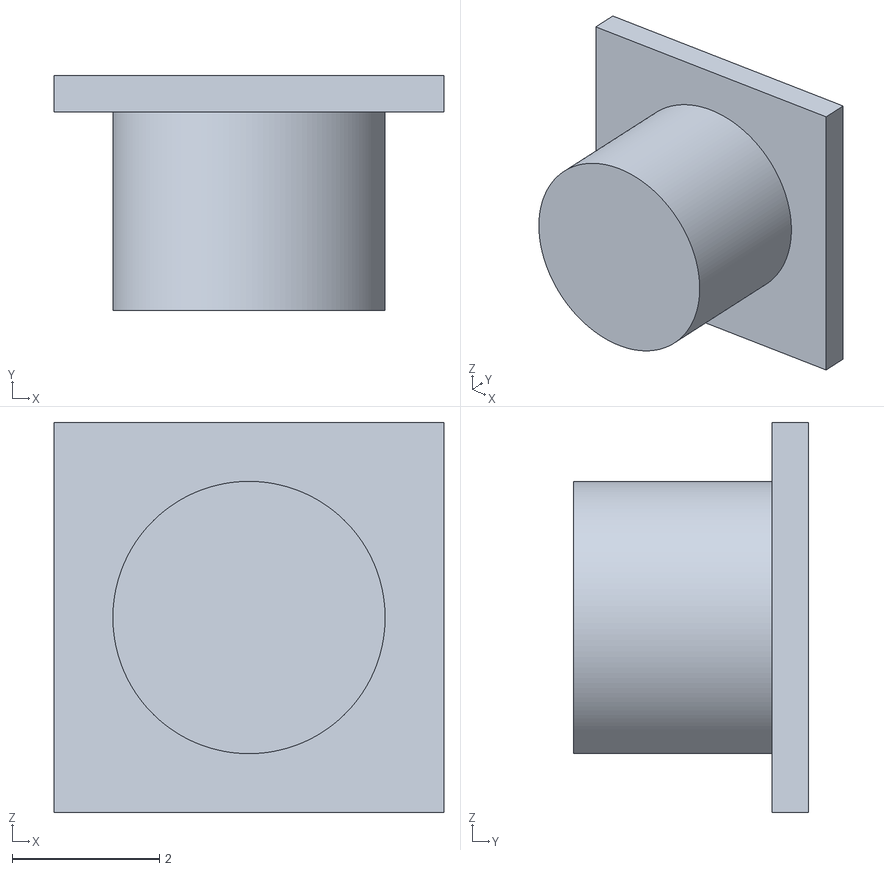
[picture p136: CAD file, 2023-03-27]
docs/fusion/stl/lens1.stl
5.30 x 3.20 x 5.30
