phorton1/Arduino-theClock3/docs/fusion/dxf/min1a.dxf

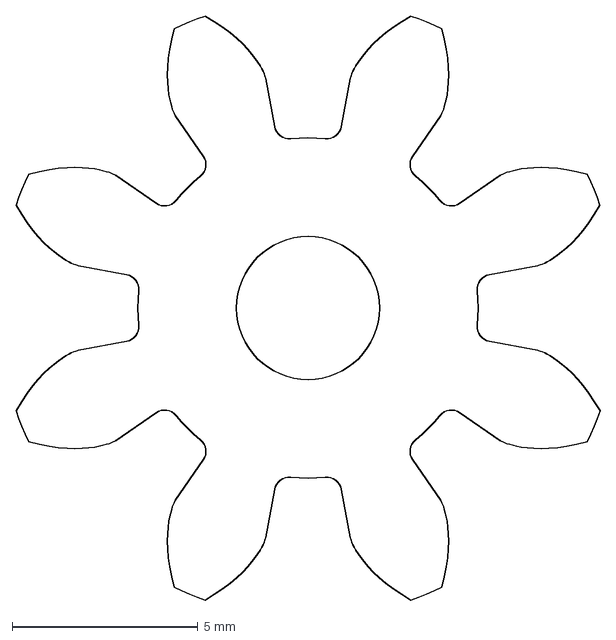
[picture p137: CAD file, 2023-03-21]
docs/fusion/dxf/min1a.dxf
15.7 x 15.7 mm
