phorton1/Arduino-theClock3/docs/fusion/stl/bobbin.stl

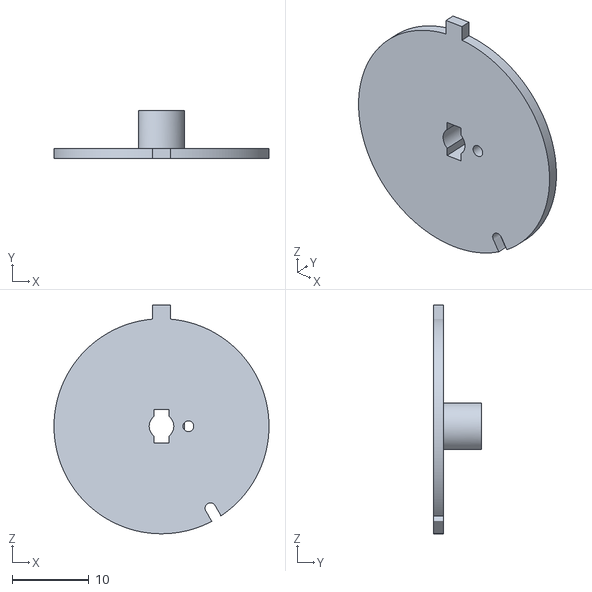
[picture p139: CAD file, 2023-03-21]
docs/fusion/stl/bobbin.stl
28.0 x 6.30 x 29.8
