phorton1/Arduino-theClock3/docs/fusion/dxf/spacers_rider_front.dxf

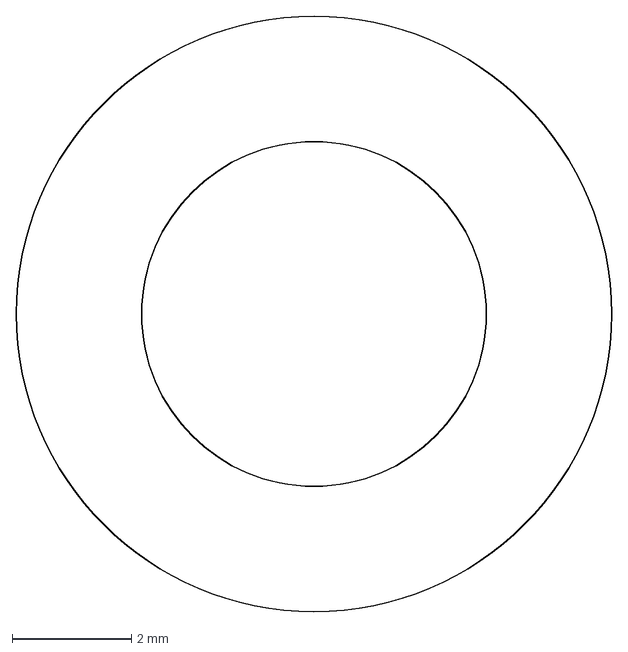
[picture p140: CAD file, 2023-03-21]
docs/fusion/dxf/spacers_rider_front.dxf
10.0 x 10.0 mm
