phorton1/Arduino-theClock3/docs/fusion/dxf/seconds_hand.dxf

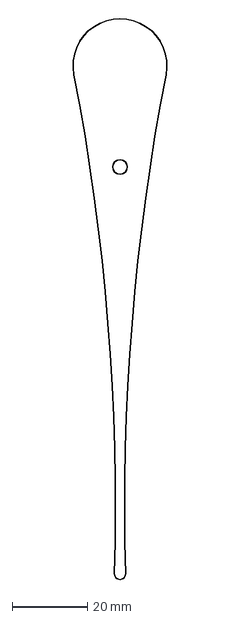
[picture p141: CAD file, 2023-03-21]
docs/fusion/dxf/seconds_hand.dxf
26.5 x 150.3 mm
