phorton1/Arduino-theClock3/docs/fusion/dxf/face.dxf

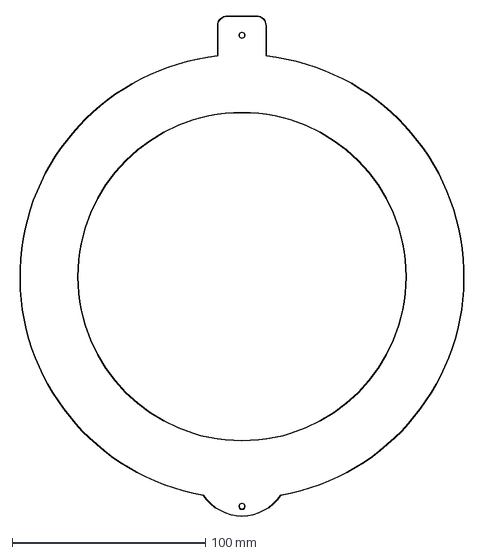
[picture p142: CAD file, 2023-03-21]
docs/fusion/dxf/face.dxf
233.6 x 259.0 mm
