phorton1/Arduino-theClock3/docs/fusion/dxf/spacers_top_tube_start.dxf

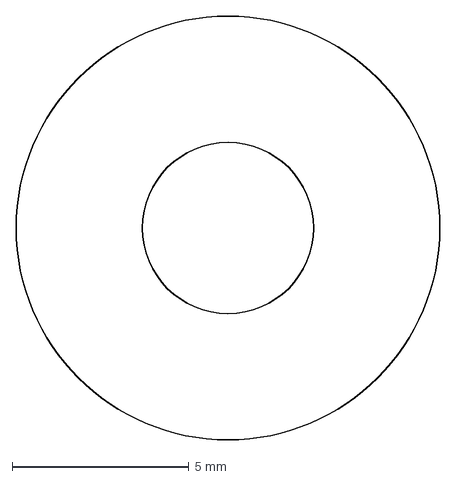
[picture p143: CAD file, 2023-03-21]
docs/fusion/dxf/spacers_top_tube_start.dxf
12.0 x 12.0 mm
