phorton1/Arduino-theClock3/docs/fusion/dxf/min2b.dxf

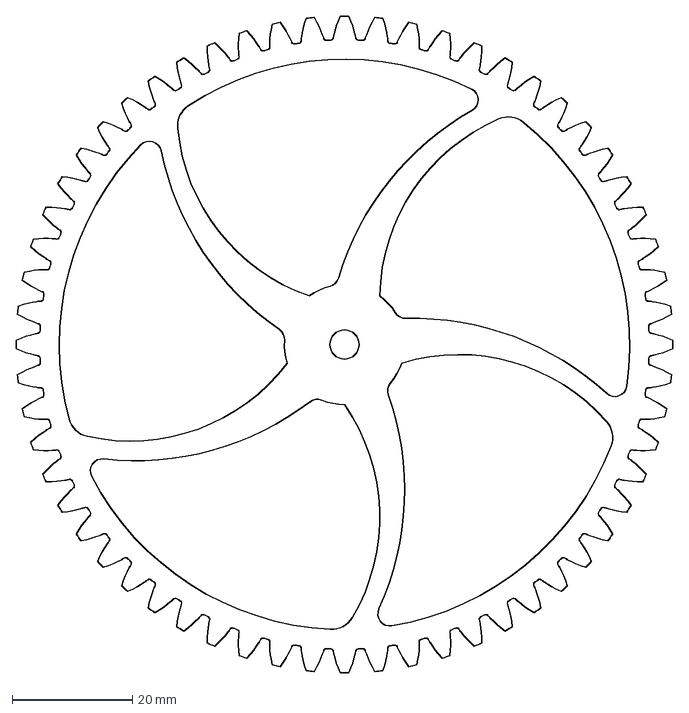
[picture p144: CAD file, 2023-03-21]
docs/fusion/dxf/min2b.dxf
109.4 x 109.4 mm
