phorton1/Arduino-theClock3/docs/fusion/dxf/tick_rects.dxf

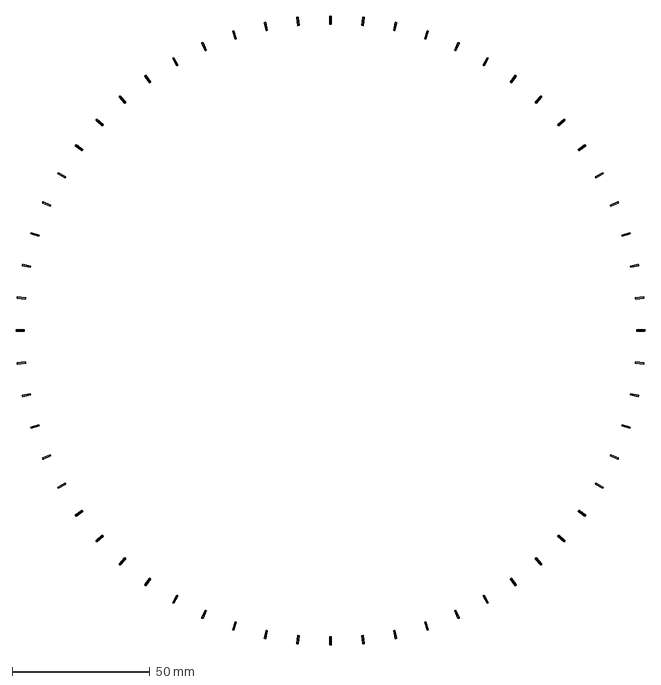
[picture p145: CAD file, 2023-03-21]
docs/fusion/dxf/tick_rects.dxf
228.0 x 228.0 mm
