phorton1/Arduino-theClock3/docs/fusion/dxf/hour2b.dxf

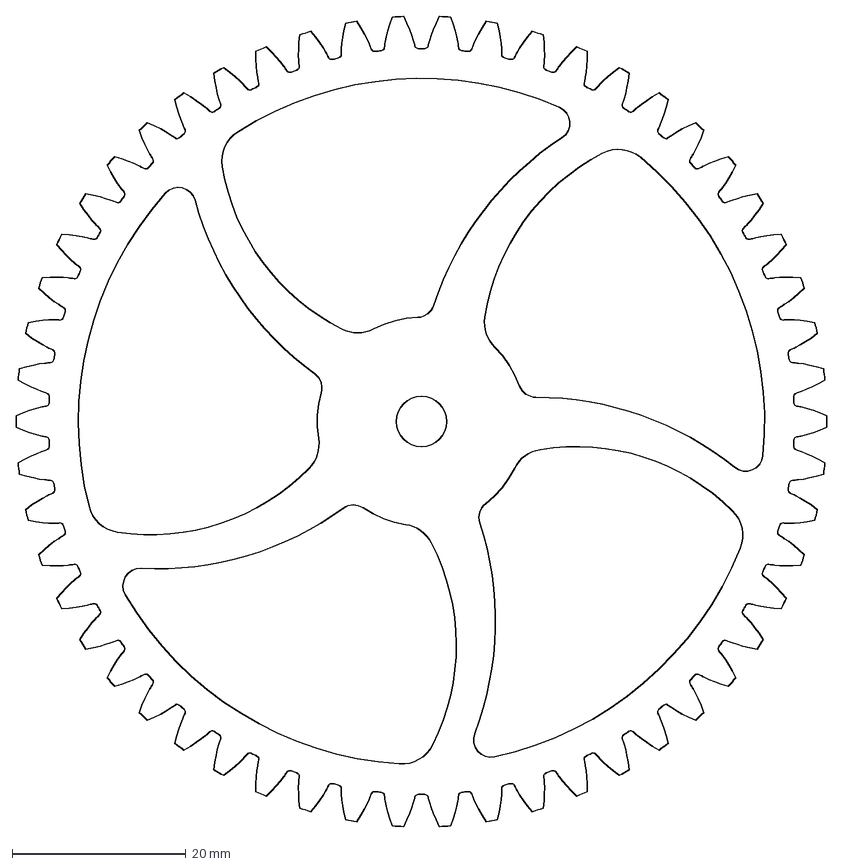
[picture p146: CAD file, 2023-03-21]
docs/fusion/dxf/hour2b.dxf
93.4 x 93.3 mm
