phorton1/Arduino-theClock3/docs/fusion/dxf/wheel.dxf

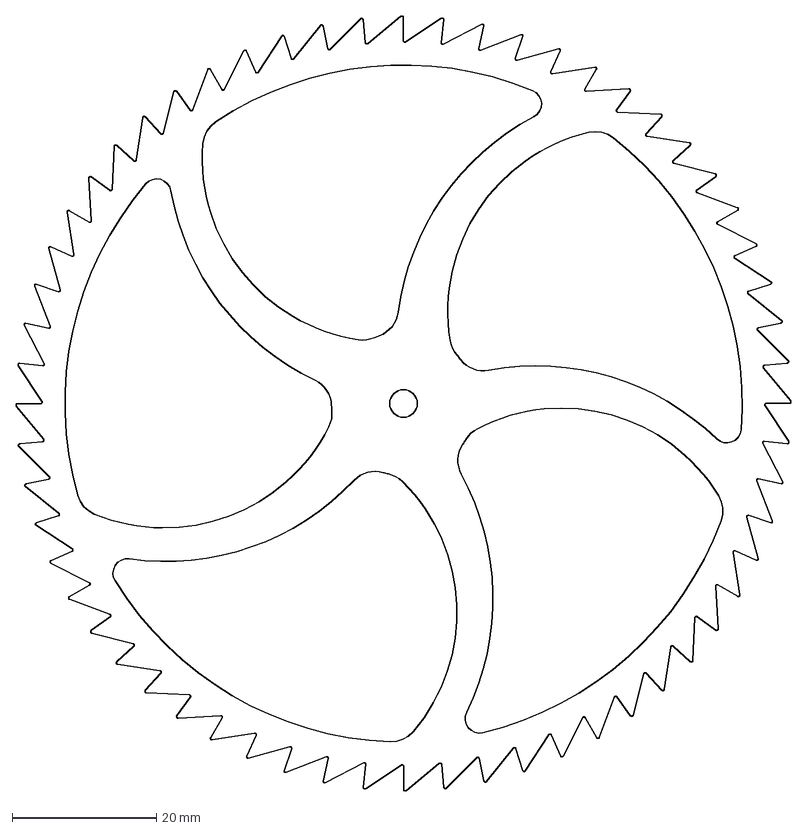
[picture p147: CAD file, 2023-03-21]
docs/fusion/dxf/wheel.dxf
107.6 x 107.6 mm
