phorton1/Arduino-theClock3/docs/fusion/dxf/frame_top.dxf

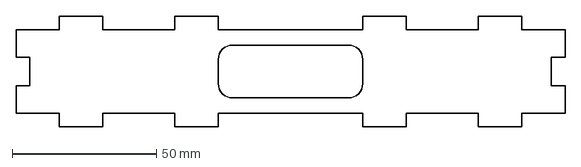
[picture p148: CAD file, 2023-03-21]
docs/fusion/dxf/frame_top.dxf
190.0 x 38.3 mm
