phorton1/Arduino-theClock3/docs/fusion/dxf/hour1b.dxf

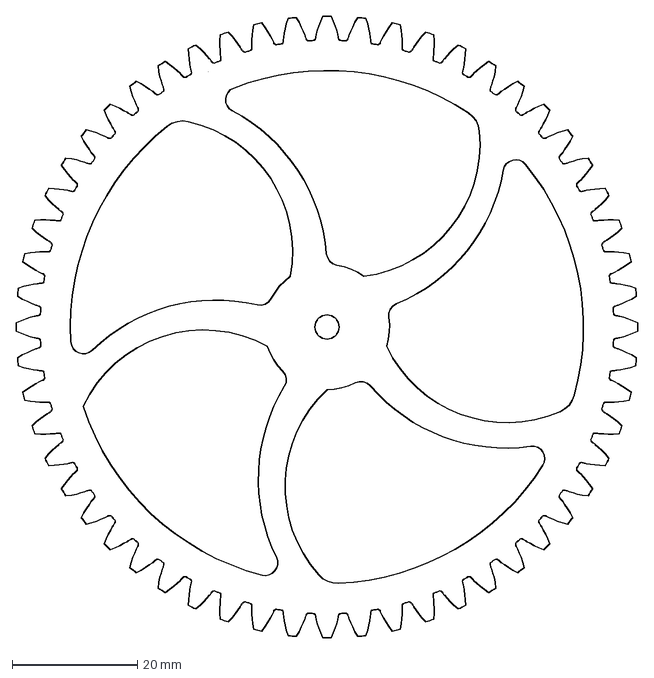
[picture p149: CAD file, 2023-03-21]
docs/fusion/dxf/hour1b.dxf
99.4 x 99.4 mm
