phorton1/Arduino-theClock3/docs/fusion/dxf/numbers.dxf

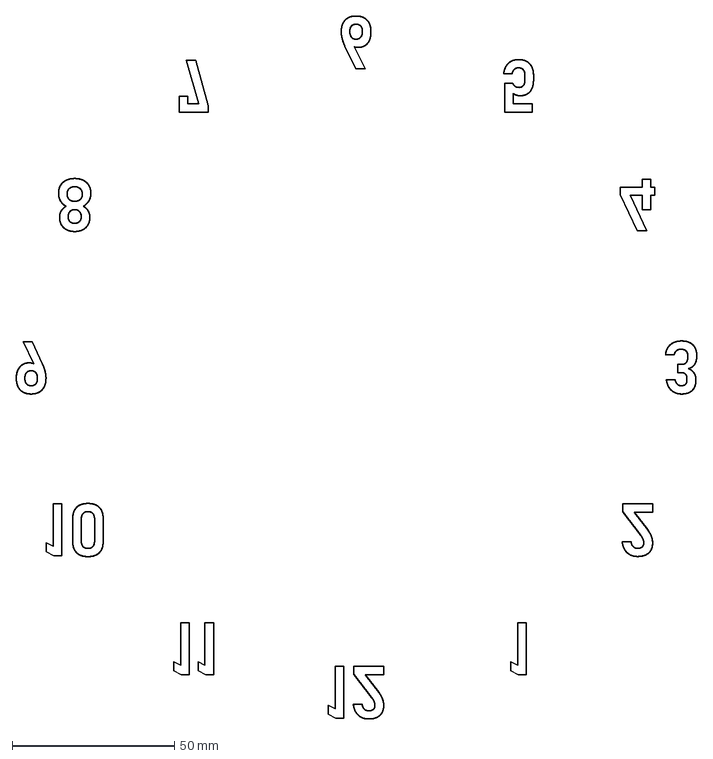
[picture p150: CAD file, 2023-03-21]
docs/fusion/dxf/numbers.dxf
209.4 x 216.3 mm
