phorton1/Arduino-theClock3/docs/fusion/dxf/hour2a.dxf

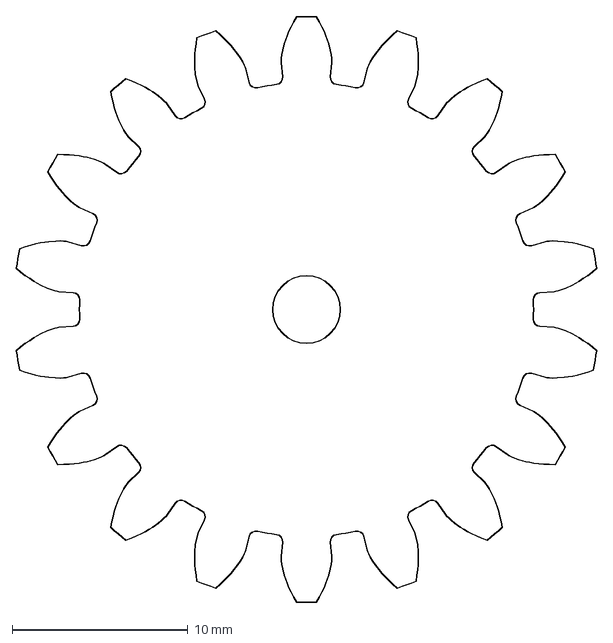
[picture p151: CAD file, 2023-03-21]
docs/fusion/dxf/hour2a.dxf
33.0 x 33.4 mm
