phorton1/Arduino-theClock3/docs/fusion/dxf/hours_hand.dxf

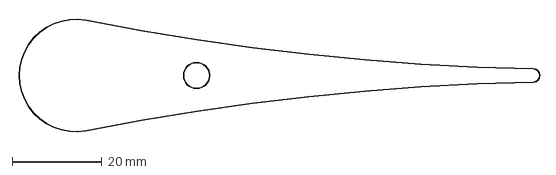
[picture p153: CAD file, 2023-03-21]
docs/fusion/dxf/hours_hand.dxf
116.7 x 26.5 mm
