phorton1/Arduino-theClock3/docs/fusion/dxf/minutes_hand.dxf

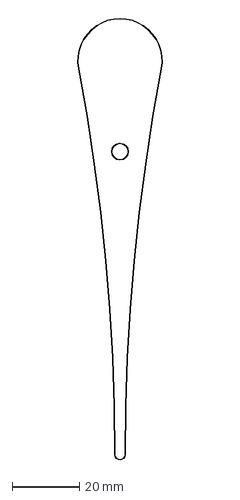
[picture p154: CAD file, 2023-03-21]
docs/fusion/dxf/minutes_hand.dxf
26.4 x 131.7 mm
