phorton1/Arduino-theClock3/docs/fusion/dxf/hour_spacer.dxf

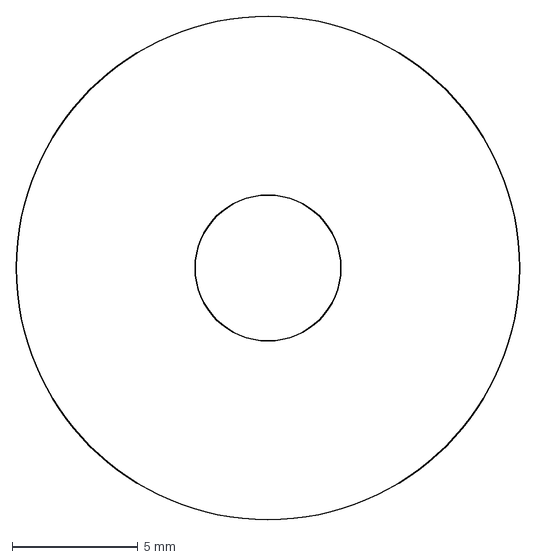
[picture p155: CAD file, 2023-03-21]
docs/fusion/dxf/hour_spacer.dxf
20.0 x 20.0 mm
