phorton1/Arduino-theClock3/docs/fusion/dxf/min1b.dxf

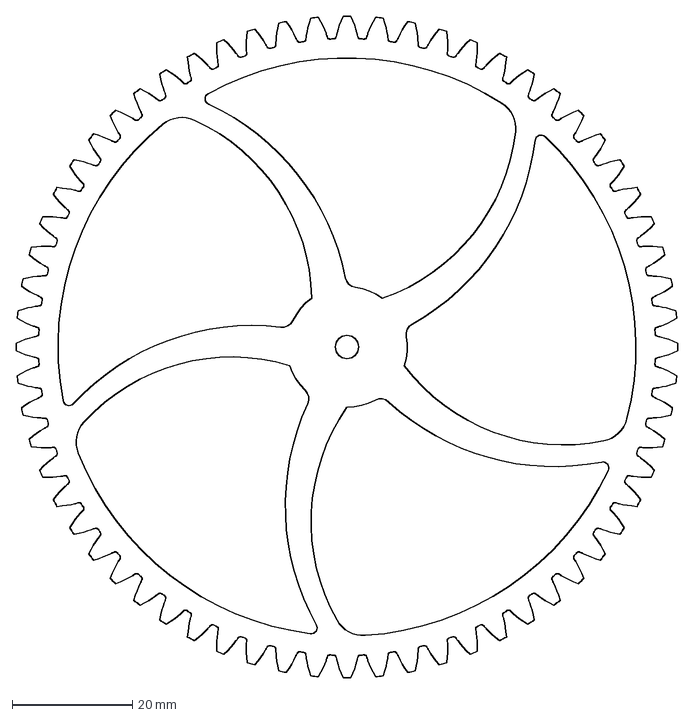
[picture p156: CAD file, 2023-03-21]
docs/fusion/dxf/min1b.dxf
110.0 x 110.0 mm
