phorton1/Arduino-theClock3/(list of files, cad)

Other CAD files:
docs/prusa/the_box_ups.3mf
docs/prusa/the_box.3mf
docs/fusion/stl/the_box_ups.stl
docs/fusion/stl/the_box.stl
docs/prusa/the_box_usb.3mf
docs/fusion/stl/magnet_holder.stl
docs/fusion/stl/wire_tie1.stl
docs/fusion/stl/sensor_housing.stl
docs/fusion/UPS.f3z
docs/fusion/stl/washer.stl
docs/prusa/washers.3mf
