phorton1/Arduino-theClock3/docs/kicad/pcb1.4/pcb.kicad_pcb

## KiCad design docs/kicad/pcb1.4/pcb.kicad_pcb (2024-01-07)

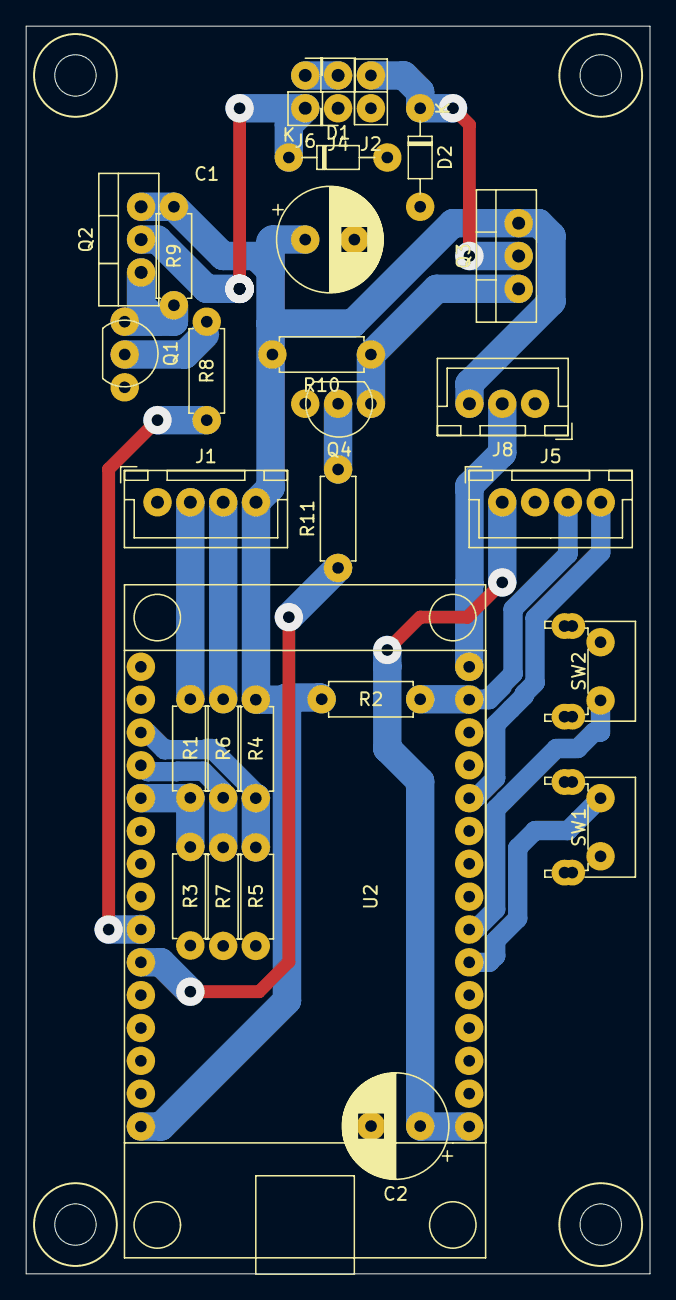
[picture p201: board docs/kicad/pcb1.4/pcb.kicad_pcb from above]

Board: 2 copper layers, 48.3 x 96.5 mm, 28 parts (0 on the bottom side), 22 nets.

Parts:
C1: 330uf; CP_my100uf
C2: 100 uf; CP_my100uf
D1, D2: 1N4741; myZenerDiode
J1: power; myJSTx04
J2: coil3; myPinSocket_1x02
J4: coil1; myPinSocket_1x02
J5: Sensor; myJSTx04
J6: coil2; myPinSocket_1x02
J8: leds; myJSTx03
Q1, Q4: BC548; myTransistor
Q2, Q3: IRF9540N; myThreeLegged
R1, R2, R3, R4, R5, R6, R7, R8, R9, R10, R11: 10K; myResistor
SW1, SW2: SW; myButtonAngled
U2: ESP32_DEV_0; myESP32DEV0

Connections:
+3V3: C2.1, J5.1, U2.30
+5V: C1.1, J1.4, J8.3, Q2.3, Q3.3, R2.1, R4.2, R9.2, R10.2, U2.1
COIL1+: D1.1, J6.2, Q2.2
COIL2+: D2.1, J2.2, Q3.2
GND: C1.2, C2.2, D1.2, D2.2, J1.1, J2.1, J4.1, J5.2, J8.1, Q1.3, Q4.3, R3.2, R5.2, R7.2, SW1.2, SW2.1, U2.2, U2.29
LEDS: J8.2, U2.16
unnamed: J4.2, J6.1
unnamed: Q1.1, Q2.1, R9.1
unnamed: Q1.2, R8.2
unnamed: Q3.1, Q4.1, R10.1
unnamed: Q4.2, R11.2
PWM1: R8.1, U2.7
PWM2: R11.1, U2.6
S5V: R4.1, R5.1, U2.13
SBAT: R1.1, R3.1, U2.11
SBUS: R6.1, R7.1, U2.12
SCL: J5.3, R2.2, U2.17
SDA: J5.4, U2.20
SW1: SW1.1, U2.25
SW2: SW2.2, U2.24
VBAT: J1.2, R1.2
VBUS: J1.3, R6.2
