phorton1/Arduino-theClock3/docs/kicad/pcb3.1/pcb.kicad_pcb

## KiCad design docs/kicad/pcb3.1/pcb.kicad_pcb (2023-05-08)

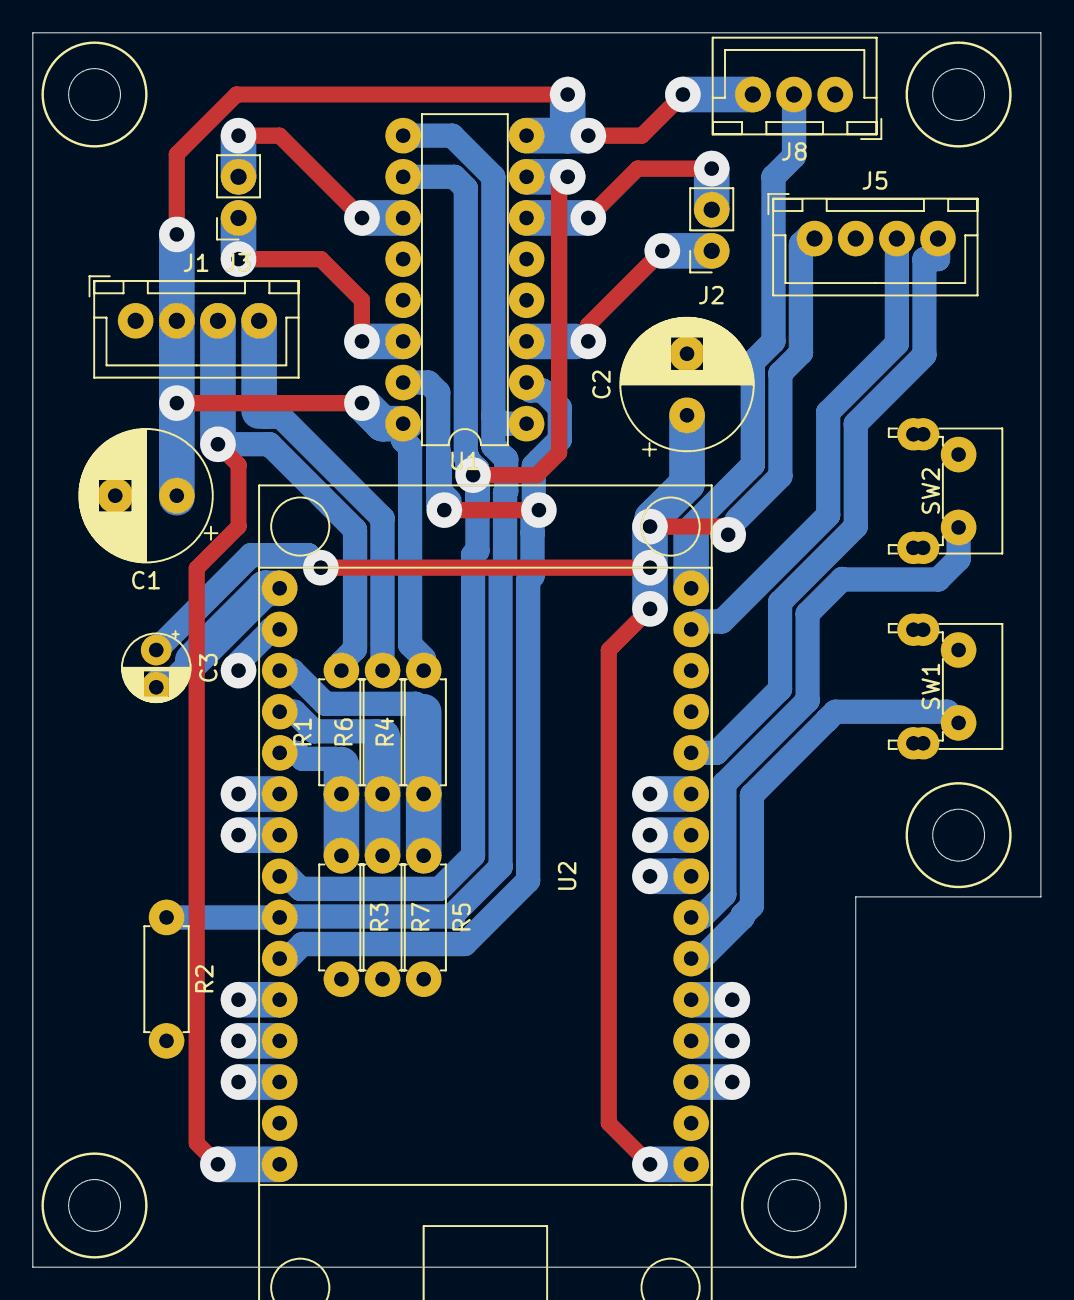
[picture p202: board docs/kicad/pcb3.1/pcb.kicad_pcb from above]

Board: 2 copper layers, 62.2 x 76.2 mm, 19 parts (0 on the bottom side), 21 nets.

Parts:
C1: 100uf; CP_my100uf
C2: 470uf; CP_my100uf
C3: 10uf; CP_my10uf
J1: power; myJSTx04
J2: coil1; myPinSocket_1x02
J3: coil2; myPinSocket_1x02
J5: Sensor; myJSTx04
J8: leds; myJSTx03
R1, R2, R3, R4, R5, R6, R7: 10K; myResistor
SW1, SW2: SW; myButtonAngled
U1: L293D; myDip16
U2: ESP32_DEV_0; myESP32DEV0

Connections:
+3V3: C2.1, C3.1, J5.1, U2.30
+5V: C1.1, J1.2, J8.3, R4.2, U1.8, U1.16
EN: R2.1, U1.1, U1.9, U2.7
GND: C1.2, C2.2, J1.1, J5.2, J8.1, R2.2, R3.2, R5.2, R7.2, SW1.1, SW2.1, U1.4, U1.5, U1.12, U1.13, U2.2, U2.29
I1: U1.2, U1.15, U2.6
I2: U1.7, U1.10, U2.8
LEDS: J8.2, U2.16
unnamed: C3.2, U2.15
OA1: J2.1, U1.3
OA2: J2.2, U1.6
OB1: J3.1, U1.14
OB2: J3.2, U1.11
S5V: R4.1, R5.1, U2.13
SBAT: R6.1, R7.1, U2.12
SBUS: R1.1, R3.1, U2.11
SCL: J5.3, U2.17
SDA: J5.4, U2.20
SW1: SW1.2, U2.25
SW2: SW2.2, U2.24
VBAT: J1.4, R6.2
VBUS: J1.3, R1.2, U2.1
