phorton1/Arduino-theClock3/theClock3.h

#pragma once

#include <myIOTDevice.h>


#define CLOCK_COMPILE_VERSION    3		// 1, 2, 3
	// 1 == version 1.4 MOSFET PCB
	//		My origianal clock 1.0/1, modified by adding an AS5600 sensor
	//      and a second coil for an explicit "spring".
	// 2 == CHRIS'S CLOCK and PAMELAS CLOCK
	//		the three clocks I made as gifts, two of which were gifted
	//      on 2023-06-08, using lm293 motor driver IC
	// 3 == the original v3 clock with new MOSFET power board
	//      and DANIELS v3 clock as well


// VOLTAGE CHECKS and associated LOW_POWER_MODE are only
// compiled in for specific clocks.

#if 1
	#define WITH_VOLTAGES   	1
	#define VOLT_MODE_NORMAL    0
	#define VOLT_DETECT_LOW     1
	#define VOLT_MODE_LOW		2
#else
	#define WITH_VOLTAGES   	0
#endif


//--------------------------------
// Critical Angle Constants
//--------------------------------

#define MIN_ZERO_ANGLE          90.0			// criteria for successful setZeroAngle
#define MAX_ZERO_ANGLE			270.0			// criteria for successful setZeroAngle
#define MAX_ALLOWABLE_ANGLE  	20.0			// adjusted angles greater than this will be ignored in run()


//---------------------------------
// pin assignments
//---------------------------------

#if WITH_VOLTAGES
	#if CLOCK_COMPILE_VERSION == 1
		#define PIN_VOLTS_5V		39
		#define PIN_VOLTS_VBUS  	34
	#else
		#define PIN_VOLTS_5V		39
		#define PIN_VOLTS_VBUS  	35
	#endif
#endif



// L293D motor driver
// vs MOSFET motor driver

#if CLOCK_COMPILE_VERSION == 2
	#define PIN_IN1		27
	#define PIN_IN2		25
	#define PIN_EN		26
#else
	#define PIN_PWM		26
#endif

#if CLOCK_COMPILE_VERSION == 1
	#define PIN_PWM2	27
#endif


// Rotary Sensor(s) uses Wire Defaults
// #define PIN_SDA	21
// #define PIN_SCL	22


// Leds and Buttons

#define PIN_LEDS	23	// overuse MOSI
#define PIN_BUTTON1 16	// RX2
#define PIN_BUTTON2 17	// TX2
#define NUM_BUTTONS 2


// Pixels
// Note that pixels are backwards (left to right == 4..0)

#define PIXEL_MAIN		4
#define PIXEL_STATE     3
#define PIXEL_ACCURACY  2
#define PIXEL_CYCLE     1
#define PIXEL_SYNC      0

#define NUM_PIXELS		5


//----------------------------------
// available LED colors
//----------------------------------

#define MY_LED_BLACK    0x000000
#define MY_LED_RED      0x440000
#define MY_LED_GREEN    0x003300
#define MY_LED_BLUE     0x000044
#define MY_LED_CYAN     0x003322
#define MY_LED_YELLOW   0x333300
#define MY_LED_MAGENTA  0x440044
#define MY_LED_WHITE    0x444444
#define MY_LED_ORANGE   0x402200
#define MY_LED_REDMAG   0x400022
#define MY_LED_PURPLE   0x220022
#define MY_LED_BLUECYAN 0x002240


//--------------------------------
// from nptTime.cpp
//--------------------------------

#define CLOCK_WITH_NTP   1

#if CLOCK_WITH_NTP
	extern bool getNtpTime(int32_t *secs, int32_t *ms);
	extern void syncNTPTime();
#endif


//------------------------
// theClock definition
//------------------------

#define ID_START_SYNC		"START_SYNC"
#define ID_RUNNING			"RUNNING"
#define ID_CLOCK_MODE		"CLOCK_MODE"
#define ID_PLOT_TYPE		"PLOT_TYPE"

#define ID_LED_BRIGHTNESS	"LED_BRIGHTNESS"

#define ID_CLOCK_TYPE		"CLOCK_TYPE"

#define ID_SET_ZERO_ANGLE	"SET_ZERO_ANGLE"
#define ID_ZERO_ANGLE		"ZERO_ANGLE"
#define ID_ZERO_ANGLE_F		"ZERO_ANGLE_F"
#define ID_DEAD_ZONE		"DEAD_ZONE"
#define ID_ANGLE_START		"ANGLE_START"
#define ID_ANGLE_MIN		"ANGLE_MIN"
#define ID_ANGLE_MAX		"ANGLE_MAX"

#if CLOCK_COMPILE_VERSION == 1
	#define ID_SPRING_DELAY     "SPRING_DELAY"
	#define ID_SPRING_DUR      	"SPRING_DUR"
	#define ID_SPRING_POWER     "SPRING_POWER"
#endif

#define ID_POWER_MIN      	"POWER_MIN"
#define ID_POWER_PID      	"POWER_PID"
#define ID_POWER_MAX      	"POWER_MAX"
#define ID_POWER_START      "POWER_START"

#define ID_DUR_PULSE      	"DUR_PULSE"
#define ID_DUR_START		"DUR_START"

#define ID_PID_P			"PID_P"
#define ID_PID_I			"PID_I"
#define ID_PID_D			"PID_D"

#define ID_APID_P			"APID_P"
#define ID_APID_I			"APID_I"
#define ID_APID_D			"APID_D"

#define ID_RUNNING_ANGLE	"RUNNING_ANGLE"
#define ID_RUNNING_ERROR	"RUNNING_ERROR"
#define ID_MIN_MAX_MS		"MIN_MAX_MS"
#define ID_START_DELAY		"START_DELAY"

#define ID_CYCLE_RANGE 		"CYCLE_RANGE"
#define ID_ERROR_RANGE 		"ERROR_RANGE"

#define ID_CLEAR_STATS		"CLEAR_STATS"
#define ID_CLEAR_ERRORS		"CLEAR_ERRORS"

#define ID_STAT_MSG0		"STAT_MSG0"
#define ID_STAT_MSG1		"STAT_MSG1"
#define ID_STAT_MSG2		"STAT_MSG2"
#define ID_STAT_MSG3		"STAT_MSG3"
#define ID_STAT_MSG4		"STAT_MSG4"
#define ID_STAT_MSG5		"STAT_MSG5"
#define ID_STAT_MSG6		"STAT_MSG6"

#define ID_STAT_INTERVAL	"STAT_INTERVAL"
#define ID_SYNC_INTERVAL	"SYNC_INTERVAL"
#define ID_SYNC_RTC			"SYNC_RTC"

#if CLOCK_WITH_NTP
	#define ID_NTP_INTERVAL	"NTP_INTERVAL"
	#define ID_SYNC_NTP		"SYNC_NTP"
#endif

#if WITH_VOLTAGES
	#define ID_VOLT_INTERVAL 	"VOLT_INTERVAL"		// seconds between voltage checks, default 0=off
	#define ID_VOLT_CALIB	 	"VOLT_CALIB"		// calibration of voltages
	#define ID_VOLT_CUTOFF	 	"VOLT_CUTOFF"		// vbus volts at which to enter low power mode
	#define ID_VOLT_RESTORE	 	"VOLT_RESTORE"		// vbus volts at which to leave low power mode
	#define ID_LOW_POWER_EN 	"LOW_POWER_EN"	    // enables actually going into low power mode
#endif


#define ID_TEST_COILS		"TEST_COILS"
	// ANY CHANGES will call motor(value) directly!!
#if CLOCK_COMPILE_VERSION == 1
	#define ID_TEST_SPRING	"TEST_SPRING"
#endif

#define ID_CHANGE_CLOCK		"CHANGE_CLOCK"
	// Will add given number of seconds to ESP32 clock
	// for testing sync code

// enumerated type values

#define CLOCK_STATE_NONE    	0
#define CLOCK_STATE_START		1
#define CLOCK_STATE_STARTED		2
#define CLOCK_STATE_RUNNING		3

#define CLOCK_MODE_SENSOR_TEST	0
#define CLOCK_MODE_POWER_MIN	1
#define CLOCK_MODE_POWER_MAX    2
#define CLOCK_MODE_ANGLE_START	3
#define CLOCK_MODE_ANGLE_MIN 	4
#define CLOCK_MODE_ANGLE_MAX	5
#define CLOCK_MODE_MIN_MAX		6
#define CLOCK_MODE_PID          7


#define PLOT_CYCLES				0
#define PLOT_WAVES				1


#define INIT_STATS_RESTART     0
#define INIT_STATS_START_CLOCK 1
#define INIT_STATS_ALL   	   2


// theClock declaration

class theClock : public myIOTDevice
{
public:

    theClock();
    ~theClock() {}

    virtual void setup() override;
	virtual void loop() override;

	virtual bool hasPlot() override    { return true; }

private:

	// myIOT parameters

    static const valDescriptor m_clock_values[];

	static int  _clock_type;		// is it left (tock) or right (tick) at 500ms?
	static bool _start_sync;		// doing a synchronized start
	static bool _clock_running;		// user interface variable !! (as opposed to control variable)
	static uint32_t _clock_mode;
	static uint32_t _plot_type;
	static int _led_brightness;

	static int _zero_angle;			// actual used value is in as5600 units
	static float _zero_angle_f;		// displayed value is a float
	static float _dead_zone;		// degrees dead for pushing about zero
	static float _angle_start;		// target angle for clock
	static float _angle_min;
	static float _angle_max;

#if CLOCK_COMPILE_VERSION == 1
	static int _spring_delay;		// delay after motor pulse turns off before spring turns on
	static int _spring_dur;			// duration for spring to be turned on
	static int _spring_power;		// default/starting power for spring while on
#endif

	static int _power_min;			// PID mininum power, also power for !PID and motor test
	static int _power_pid;			// PID starting power
	static int _power_max;      	// PID maximum power
	static int _power_start;    	// power during startup pulse

	static int _dur_pulse;			// duration of power pulse for both PID and STATIC
	static int _dur_start;			// duration of startup pulse

	static float _pid_P;			// PID controller values
	static float _pid_I;
	static float _pid_D;

	static float _apid_P;			// PID controller values
	static float _apid_I;
	static float _apid_D;

	static float _running_angle;		// minimum angle for clock to be considered "running"
	static float _running_error;		// minimum accumulated angular error for clock to be considered running
	static int 	 _min_max_ms;			// ms threshold for min/max algorithm
	static int   _start_delay;

	static int   _cycle_range;			// range for displaying diag LED for cycles
	static int   _error_range;			// range for displaying diag LED for cumulative error

#if WITH_VOLTAGES
	static uint32_t _volt_interval;
	static float	_volt_calib;
	static float	_volt_cutoff;
	static float	_volt_restore;
	static bool		_low_power_enable;
#endif

	static String 	_stat_msg0;		// messages
	static String 	_stat_msg1;
	static String 	_stat_msg2;
	static String 	_stat_msg3;
	static String 	_stat_msg4;
	static String 	_stat_msg5;
	static String 	_stat_msg6;

	static uint32_t _stat_interval;	// interval, in beats/seconds for statistic to be displayed
	static uint32_t _sync_interval;	// interval, in beats/seconds for beats vs ESP32 clock check
#if CLOCK_WITH_NTP
	static uint32_t _ntp_interval;	// interval, in beats/seconds for NTP vs ESP32 clock check
#endif

	static int _test_coils;		// memory only, only happens onChange
#if CLOCK_COMPILE_VERSION == 1
	static int _test_spring;	// memory only, only happens onChange
#endif
	static int _change_clock;	// memory only, only happens onChange


	// clock paramters

	static int 	 	m_clock_state;
	static uint32_t m_last_change;			// millis of last noticable pendulum movement
	static  int32_t m_cur_cycle;			// millis in this 'cycle' (forward zero crossing)
	static uint32_t m_last_cycle;			// millis at previous forward zero crossing
	static uint32_t m_num_beats;			// number of beats (while clock_started && !initial_pulse_time)

	static uint32_t m_time_start;
	static uint32_t m_time_start_ms;
	static uint32_t m_time_zero;			// ESP32 RTC time at zero crossing
	static uint32_t m_time_zero_ms;			// with milliseconds (from microseconds)
	static uint32_t m_time_init;
	static uint32_t m_time_init_ms;

	static int32_t  m_total_millis_error;	// cumulative number of millis total error
	static int32_t  m_prev_millis_error;
	static float    m_pid_angle;			// angle determined by second PID controller or other parameters

	static float 	m_total_ang_error;		// accumluated degrees of error (for "I")
	static float 	m_prev_ang_error;		// the previous error (for "D")
	static int 	 	m_pid_power;			// power adjusted by pid algorithm

	static int 		m_sync_sign;			// if in a sync, the sign of sync_millis, else zero
	static int 		m_sync_millis;			// if in a sync, the amount to sync, else zero

	static uint32_t m_initial_pulse_time;	// time at which we started initial clock starting pulse (push)
	static bool 	m_push_motor;			// push the pendulum next time after it leaves deadzone (determined at zero crossing)
	static uint32_t m_motor_start;
	static uint32_t m_motor_dur;

	static uint32_t m_last_beat;
	static uint32_t m_last_stats;
	static uint32_t m_last_sync;
	static uint32_t m_last_ntp;

	static bool		m_update_stats;
	static bool     m_force_pixels;
	static bool     m_setting_zero;


	// UI methods

	static void onStartSyncChanged(const myIOTValue *desc, bool val);
    static void onClockRunningChanged(const myIOTValue *desc, bool val);
    static void onClockModeChanged(const myIOTValue *desc, uint32_t val);
	static void onPlotValuesChanged(const myIOTValue *desc, uint32_t val);
	static void onPixelModeChanged(const myIOTValue *desc, uint32_t val);
	static void onBrightnessChanged(const myIOTValue *desc, uint32_t val);
	static void clearStats();
	static void clearErrors();
	static void setZeroAngle();
	static void onSyncRTC();

	#if CLOCK_WITH_NTP
		static void onSyncNTP();
	#endif

	// UI test methods

	static void onTestCoils(const myIOTValue *desc, int val);
	#if CLOCK_COMPILE_VERSION == 1
		static void onTestSpring(const myIOTValue *desc, int val);
	#endif
	static void onChangeClock(const myIOTValue *desc, int val);

	// Internal Private methods


	static void setClockState(int state);
	static void initMotor();
	static void initStats();
	static void motor(int power);
	#if CLOCK_COMPILE_VERSION == 1
		static void spring(int power);
		static bool m_spring_on;			// we are using the spring to speed up
		static uint32_t m_push_spring;      // push the spring after this time
		static uint32_t m_spring_start;		// time at which the spring started
		static int m_spring_power;			// working power for spring on ..
		static int getSpringPower();
	#else
		static float getPidAngle();
	#endif

	static void run();
	static void clockTask(void *param);
	static void startClock(bool restart=0);
	static void stopClock();


	static int getPidPower(float avg_angle);

	void doPixels();
	void doButtons();
	void showStats();

	#if WITH_VOLTAGES
		static float m_volts_5v;
		static float m_volts_vbus;
		static int m_low_power_mode;
		static uint32_t m_low_power_time;

		void checkVoltage();
		void setLowPowerMode(bool low);
	#endif

};	// class theClock


extern const char *plot_legend_cycles;
extern const char *plot_legend_waves;
	// in theClockRun, close to where the plots are produced
	

extern theClock *the_clock;
