phorton1/Arduino-theClock3/(commit log)

2023-03-16 copy files from theClock/pcb1.1, rename, and check in
    [pcb.kicad_pcb, pcb.sch]
2023-03-17 initial v3 circuit board, pin assigments in code TODO: code in general
    [clock_params3.0.csv, pcb.kicad_pcb, pcb.sch]
2023-03-21 correct 5165 to 5155!! bearing
    [clock_params3.0.csv]
2023-03-21 create and build circuit board
    [pcb.kicad_pcb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]
2023-03-21 build wood and plastic
    [arms.dxf, bobbin.stl, box_top.dxf, bridge_back.dxf, bridge_front.dxf, bridge_support_front.dxf, bridge_support_left.dxf, bridge_support_top.dxf]
2023-03-21 revert to 5165 bearing
    [bridge_front.dxf, clock_params3.0.csv, frame_back.dxf]
2023-03-22 changed to 2.6 screw3_tight_wood, updated drawings, got rid of most lightburn for eas of maintenance
    [arms.dxf, bridge_back.dxf, bridge_front.dxf, bridge_support_front.dxf, clock_params3.0.csv, frame_front.dxf, frame_main.dxf, rider.dxf]
2023-03-25 checking 3.1 before changing it to 3.0
    [clock_params3.1.csv, lengths.csv, pcb.kicad_pcb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]
2023-03-25 change 3.1 to 3.0 and generate flatcam stuff
    [box_top.dxf, bridge_back.dxf, bridge_front.dxf, bridge_support_front.dxf, bridge_support_left.dxf, bridge_support_top.dxf, clock_params3.0.csv, clock_params3.1.csv]
2023-03-27 build thinner v3.0
    [cam.dxf, cam2.dxf, frame_main.dxf, house_top.dxf, lens1.stl, lenses.3mf, pendulum_covers_and_spacers.dxf, the_box.3mf]
2023-03-30 initial commit of swing degree PID controller
2023-03-30 added a wire tie
    [wire_tie1.3mf]
2023-03-30 fixed magnet sixe in pendulum
    [pendulum.dxf]
2023-03-30 various minor physical changes
    [arms.dxf, washer.stl, washers.3mf, wire_tie1.stl]
2023-03-30 added alternate arm2 and pawl2
    [alt_arms.dxf, alt_pawls.dxf]
2023-03-30 standardize on new pawl2
    [alt_arms.dxf, alt_pawls.dxf, pawls.dxf]
2023-03-30 remove HALL, cleanup, initial STATS
2023-03-31 initial working checkin (BEFORE SOLVING BASIC FREQUENCY ISSUE)
    [theClock3.cpp, theClock3.ino]
2023-04-02 initial ntp and error correction
    [nptTime.cpp, theClock3.cpp, theClock3.h, theClock3.ino]
2023-04-03 sanity checkin - trying to run down AS5600 error - changed startup logic, parameterized much additional stuff, still just skips bad as5600 readings ... sigh
    [theClock3.cpp, theClock3.h, theClock3.ino]
2023-04-08 version 3.1 arms and pawls
    [arms.dxf, cam.dxf, pawls.dxf, pendulum_covers_and_spacers.dxf]
2023-04-10 2ND PID CONTROLLER - NEW ALGORITHM - NO "PULLS" - WORKS GOOD
2023-04-10 refine constants; design and print magnet_holder; prep for startClockSynchronized
    [magnet_holder.3mf, magnet_holder.stl]
2023-04-11 rework LEDS in prep for startClockSynchronized()
    [theClock3.cpp, theClock3.h, theClock3.ino]
2023-04-13 added PIXEL_MODE and LED_BRIGHTNESS; had problem with loop() static uint32_t!!! messed with IRAM_ATTR; solution? --> made many vars volatile;
    [theClock3.cpp, theClock3.h, theClock3.ino]
2023-04-15 FOUND THE MEMORY BUG! - got rid of volatiles - fixed timeAddMS *secs-- and onSyncRTC sign problem - made clearStats() really start over
    [theClock3.cpp]
2023-04-16 fixed compiler warnings and one bug with this_p = cur_cycle
    [nptTime.cpp, theClock3.cpp]
2023-04-16 implement buttons; test default values;
2023-04-17 fixed PIXEL_MODE_TIME time intervals and added m_start_sync==MY_LED_WHITE
    [theClockLoop.cpp]
2023-04-18 added button support for PIXEL_MODE_TIME and changed colors again
2023-04-19 CREATED V1.3 as clock 1.1 with V3 sensor and software
2023-04-22 added LOLIN32v3 schematic
    [pcb.sch]
2023-04-22 separated V1 PINS from BEHAVIOR so I could build LOLIN32 with correct pins, but V1 behavior
    [clockAS5600.cpp, theClock3.cpp, theClock3.h, theClock3.ino, theClockLoop.cpp, theClockRun.cpp]
2023-04-23 LOLIN32 pcb - changed voltage divider resistors
    [pcb.sch]
2023-04-23 Added WITH_VOLT_CHECK define, turns on PIN_VOLT_CHECK and parameters VOLT_VALUE, VOLT_INTERVAL, and VOLT_CALIB
2023-04-23 Retry initing AS5600 a few times if it fails
    [clockAS5600.cpp]
2023-04-23 added #define REVERSE_PIXELS for test LOLIN32 circuit; moved CLOCK_STATE_STATS functionality to run()
    [theClock3.cpp, theClock3.h, theClockLoop.cpp, theClockRun.cpp]
2023-04-23 moved REVERSE_PIXELS up - checked in with LOLIN32 test circuit defines
    [theClock3.h]
2023-04-25 added lolin32 pcb & step; started 5VUPS schematic
    [5vUPS.kicad_pcb, 5vUPS.sch, pcb.kicad_pcb, pcb.sch]
2023-04-28 added 3.1 pcb, dxfs, prepare to build
    [arms.dxf, arms3.0.dxf, arms3.1.dxf, cam.dxf, cam3.0.dxf, cam3.1.dxf, frame_main.dxf, frame_main3.0.dxf]
2023-05-01 rebuild normal ESP32_dev0
2023-05-08 build 3 x v3.2
    [clock_params3.2.csv, frame_back3.2.dxf, frame_front3.2.dxf, frame_left3.2.dxf, frame_main3.2.dxf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]
2023-05-09 finish wood build
    [bobbins_x2.3mf]
2023-05-12 diddle params again, add BOM, and washer_x8.gcode
    [clock3.2_bom.xlsx]
2023-05-21 various extra files generated while building 3 x v3.2 clocks
    [15x13_bearing_adapter.3mf, 15x13_bearing_adapter.stl, clock3.2_bom.xlsx, lenses_x3.3mf]
2023-05-21 upgrade to version 3.2 and default correct clock3 pins
    [theClock3.h, theClock3.ino]
2023-05-27 NORMALIZE RELEASE TO 3.2 - rename many files, move 3.0, 3.1 to /dat, save fusion file
    [5vUPS.kicad_pcb, 5vUPS.sch, arms.dxf, arms3.0.dxf, arms3.1.dxf, cam.dxf, cam3.0.dxf, cam3.1.dxf]
2023-06-01 FINALISH BUILD THREE CLOCKS - lots of changes changed startAS5600 to flash all LEDs upon failure, and for CLOCK_STATE led to flash red in that case. changed setZeroAngle() to retry upto 5 times 45 to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
    [usb_micro_mount.3mf, usb_micro_mount.stl]
2023-06-07 initial commit of preliminary documentation
    [clock3.2_bom.xlsx]
2023-06-08 added QuickStartGuide.docx, removed versioned output files
    [magnet_holder.3mf, magnet_holder.stl, magnet_holder_v3.0.3mf, magnet_holder_v3.1.3mf, magnet_holder_v3.1.stl, the_box.3mf, the_box.stl, the_box_v3.1.3mf]
2023-06-14 documentation WIP - add Build and Firmware pages; cleanup lightburn and prusa materials
    [bobbins_x2.3mf, lenses.3mf, lenses_x3.3mf, usb_micro_mount.3mf, washers.3mf]
2023-06-16 documentation WIP - changed "rider" to "bridge" and "frame main" to "frame middle"
    [bridge.dxf, clock_params3.2.csv, frame_main.dxf, frame_middle.dxf, rider.dxf]
2023-06-16 Docs - add link(s) to new Arduino-CoilWindingMachine repository
2023-06-17 Docs - renamed fusion tool parts to "Left" and "Right", finished "Coils" page and renamed "Plastic" to "Box"
    [coil_set.3mf, tool_back.stl, tool_front.stl, tool_left.stl, tool_right.stl]
2023-06-21 PCB v3.3
    [pcb.kicad_pcb, pcb.sch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]
2023-06-21 updated pcb3.3 (no plots, flatcam, or gcode)
    [pcb.kicad_pcb, pcb.sch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]
2023-06-21 changed v3.3 defaults for SERIES coils with mosfet board. Implemented negative start_delay AFTER zero. Set default RESSTART_MIILLIS=0
2023-06-24 Rework PCB3.3, import it into fusion, more documentation WIP
    [pcb.kicad_pcb, pcb.sch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]
2023-06-24 reworked WITH_VOLTAGES and low_power_mode; tested UPS
    [clockStats.cpp, clockStats.h, theClock3.cpp, theClock3.h, theClock3.ino, theClockLoop.cpp]
2023-06-24 fixed bad bridge DXF file
    [bridge.dxf]
2023-06-24 fusion selection sets for USB mount and quick UPS mount for box
    [temp_ups_mount.stl, the_box.3mf, the_box.stl, the_box_ups.3mf, the_box_ups.stl, the_box_usb.3mf, the_box_usb.stl]
2023-06-25 got rid of fusion internal USB_UPS, added external USB_UPS box
    [USB_UPS.f3z, temp_ups_mount.stl, the_box_ups.3mf, the_box_ups.stl, the_box_usb.stl, ups_bottom.stl, ups_top.stl, ups_usb.3mf]
2023-06-25 added EXIT_LOW_POWER_MODE for short press right button (if in low power mode)
    [theClock3.cpp, theClock3.ino, theClockLoop.cpp]
2023-06-25 fusion usb_usp forgot an extrusion
    [USB_UPS.f3z, ups_top.stl, ups_usb.3mf]
2023-06-26 update documentation to new pcb3.3 MOSFET PCB
2023-06-27 document WIP - assembly.md
2023-06-30 docs - finished the Assembly page
2023-07-04 docs - shrink build-gears.gif image
2023-07-06 doc WIP - ui.md LEDs mostly
2023-07-06 docs ui fix startup LED image
2023-07-06 docs - Finish Parameters section of ui.md, cleanup LED image file names and various #define identifiers
2023-07-08 added ID_DEVICE_URL (link to github device repository) to SSDP and WebUI
2023-07-08 docs-notes - added optional 2nd USB connector and UPS Power Supply
    [the_box_usb.stl]
2023-07-10 doc - make USB_UPS box bigger
    [USB_UPS.f3z, ups_bottom.stl, ups_usb.3mf]
2023-07-10 changed DEFAULT_RUNNING_ERROR to 4 degrees, added PID comments for v3.2 built #3/3, fix sminor doc typos
    [theClock3.ino]
2023-11-02 fix broken links across all repos with introduction of base-apps-gitUI::repoDocs.pm
    [UPS.3mf, UPS.f3z]
2024-01-07 IMPLEMENT CLOCK 1.4 with new PCB and 2nd Spring Coil - clean up defines, etc.
    [pcb.kicad_pcb, pcb.sch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]
2024-01-10 added CLEAR_ERRORS command/id/button etc
2024-02-03 refine clock 1.4 to USE_LEFT angle for m_angle_pid for consistent spring behavior
2024-02-11 changed 1.04 to simple ALL-ON or ALL-OFF spring algorithm with new tuning
2024-09-08 comments only RETUNED PID for clock3.3
2024-09-21 submodule(data) auto_commit(83767cf1) Added a Widget tab to the main myIOT webpage; added jqplot CSS and JS files; wrote iotPlot.js prototype of charting within a "widget" - see fridgeController chec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
2024-09-25 refined myIOT plotter with LEGENDS and using device specific PLOT_TYPES if available; theClock3 implementation of PLOT_CYCLES and PLOT_WAVES
2024-09-25 submodule(data) auto_commit(331f60b7) refined myIOT plotter with LEGENDS and using device specific PLOT_TYPES if available; theClock3 implementation of PLOT_CYCLES and PLOT_WAVES
2024-09-29 submodule(data) auto_commit(416ed000) added prototype bilgeAlarm jqPlot Widget using added "alt_data_format" and custom chart_header and chart_data code in onCustomLink(). modified myIOT/data index.h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
2024-10-21 submodule(data) auto_commit(b811e3f8) move generic uiButtons to myIOTButtons; implement initial tempController uiScreen and PCB board(s)
2024-11-07 refork NMEA2000 libraries; cleanup FluidNC_Extensions::mesh.cpp() and cnc3018.h CNC_MACHINE, UI_WITH_MESH and USE_LARGE Mesh defines and compile messages - turning off default definition of UI_WITH_M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
2025-12-15 submodule(data) auto_commit(b649fc3a) iotChart.js - added scheme for setting device specific series colors
2025-12-18 submodule(data) auto_commit(1adaeb45) reworked iotChart.js incremental update scheme starting with Arduino-boat-drainPump
2025-12-18 submodule(data) auto_commit(b6ac0c88) starting in Arduino-boat-arirco, major rework of iotChart.js and how charts are implemented - use common chart.html instead of specific/extra_data/device_chart.h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
2025-12-18 submodule(data) auto_commit(a4e2ed81) change chart.html and iotChart.js to use and remove style "degree_hidden" for devices that chart things with degrees
2026-02-22 submodule(data) auto_commit(37a6a76c) added framework for chart.html to pass "data_name" to allow multiple charts per device; ALSO store most recent chart period in browser storage
2026-03-05 submodule(data) auto_commit(ecc76888) update myIOT data submodule readme.md to remove forward references to actual implmented device repos
2026-04-04 submodule(data) auto_commit(de0689cf) disable Scan/Delete endpoints and just View data records for devices that have graphs, but no SD card
2026-06-28 submodule(data) auto_commit(eadab9ea) added myIOTDataLog type LOG_COL_TYPE_INT16_10 to support volts (fridgeController)
2026-09-11 submodule(data) auto_commit(6700b423) skip sample points with temperature sensor anomolies
